KateredDesign/seedstick/THIRD_PARTY.md

# Third-party components

| Component | Where | Licence |
|---|---|---|
| **anatomy** (isometric figure kit), © 2026 Ryan, <https://github.com/wheresryan22/anatomy> | built into `docs/index.html` (light) and `docs/dark.html` | MIT |
| **U8g2** by Oliver Kraus, <https://github.com/olikraus/u8g2> | OLED library used by the firmware (not included, install via the Library Manager) | BSD 2-Clause |
| **Arduino core for the ESP32** by Espressif, <https://github.com/espressif/arduino-esp32> | board package (not included) | LGPL-2.1 |

## anatomy: MIT licence

```
MIT License

Copyright (c) 2026 Ryan

Permission is hereby granted, free of charge, to any person obtaining a copy
of this software and associated documentation files (the "Software"), to deal
in the Software without restriction, including without limitation the rights
to use, copy, modify, merge, publish, distribute, sublicense, and/or sell
copies of the Software, and to permit persons to whom the Software is
furnished to do so, subject to the following conditions:

The above copyright notice and this permission notice shall be included in all
copies or substantial portions of the Software.

THE SOFTWARE IS PROVIDED "AS IS", WITHOUT WARRANTY OF ANY KIND, EXPRESS OR
IMPLIED, INCLUDING BUT NOT LIMITED TO THE WARRANTIES OF MERCHANTABILITY,
FITNESS FOR A PARTICULAR PURPOSE AND NONINFRINGEMENT. IN NO EVENT SHALL THE
AUTHORS OR COPYRIGHT HOLDERS BE LIABLE FOR ANY CLAIM, DAMAGES OR OTHER
LIABILITY, WHETHER IN AN ACTION OF CONTRACT, TORT OR OTHERWISE, ARISING FROM,
OUT OF OR IN CONNECTION WITH THE SOFTWARE OR THE USE OR OTHER DEALINGS IN THE
SOFTWARE.
```
