KateredDesign/seedstick/docs/poster/SeedStick_Poster_A2.pdf

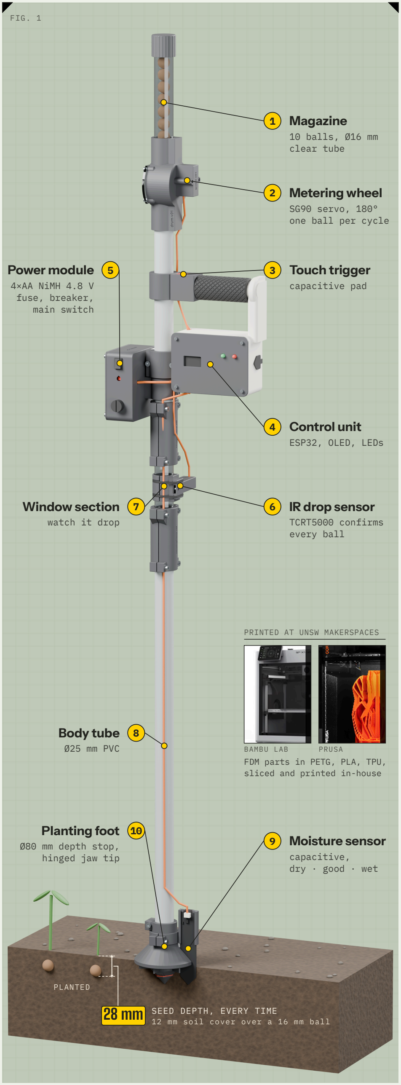
[picture p4: figure]
FIG. 1; 1 Magazine 10 balls, Ø16 mm clear tube; 2 Metering wheel SG90 servo, 180° one ball per cycle; 3 Touch trigger capacitive pad; 4 Control unit ESP32, OLED, LEDs; Power module 5 4×AA NiMH 4.8 V fuse, breaker, main switch; 6 IR drop sensor TCRT5000 confirms every ball; Window section 7 watch it drop; Body tube 8 Ø25 mm PVC; 9 Moisture sensor capacitive, dry · good · wet; Planting foot 10 Ø80 mm depth stop, hinged jaw tip; PLANTED; SEED DEPTH, EVERY TIME 12 mm soil cover over a 16 mm ball; PRINTED AT UNSW MAKERSPACES; BAMBU LAB; PRUSA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

FIG. 1 — SEEDSTICK PROTOTYPE IN THE SOIL. BLENDER RENDER.

UNSW BUILD-A-THON 2026 / RAMSOC × WIT | TRACK: RESTORATION

# SeedStick

One push.
Oneseed ball.
Every spot on record.

A hand-held planting tool for land restoration. It checks the soil, sets each seed ball at the same depth, and counts every one, so planting goes faster without losing care.

# 01 Restoration still moves at hand speed

# 1.2bn ha

of degraded land pledged for restoration by 2030

10.4%

of that area is actually under restoration today

# US$1.6tn

needed this decade, because the work is slow and manual

Seedlings are still placed by hand, a few hundred per person per day. Seeds sown over large areas often germinate poorly.

FIGURES: BUILD-A-THON 2026 BRIEF, PROBLEM 3: RESTORATION
02 Push. Read. Release. Confirm.

28

## 1 Push in

The depth stop sets
every seed ball exactly
28 mm deep.

MOISTURE

DRY GOOD WET

## 2 Read the soil

The moisture sensor
shows dry, good or wet
before you commit.

180°

## 3 Release one

A touch turns the
metering wheel 180°.
Exactly one ball drops.

+1

## 4 Confirm & log

An IR sensor sees it
pass. Count, time and
soil band are saved.

# 03 What it changes

Less labour Plant standing up: push, touch, move on. No bending, no digging, no counting.

Better starts Every ball at exactly 28 mm, and a soil check at every spot before it goes in.

Proof of work Every planting point is counted and logged, readable over the ESP32’s own Wi-Fi.

# 04 Safe by design

### Low voltage

4 × AA NiMH, 4.8 V. Far
below the 12 V limit.

### Double protection

Glass fuse plus a
resettable circuit
breaker.

### One main switch

A single rocker switch
cuts all power.

### Guarded mechanism

Wheel behind a clear
cover, servo under a
guard.

### Bolted together

Every module is bolted
on with heat-set inserts.

### 4×AA Sealed battery bay

Screwed lid: the cells
only come out with a
tool.

# Try it at ourtable

Push it in, touch the pad, and watch exactly one seed ball drop.

× | AUSTRALIA × GERMANY | The best mix of engineering. Trust theengineers.
SEEDSTICK · MECHATRONIC SOLUTION FOR ECOSYSTEM RESTORATION | FINAL SHOWCASE · 23 OCT 2026 · PRINCE HENRY CENTRE, UNSW
