KateredDesign/seedstick/hardware/bom.xlsx

SeedStick - Bill of Materials (bought and supplied parts)
Prices in AUD incl. GST. Printed parts and filament: see print-settings.md. Status: October 2026.
No. | Category | Part | Specification / part no. | Used for | Qty purchased | Unit | Qty used in SeedStick | Unit price (AUD) | Total price (AUD) | Supplier | Supply | Price basis | Notes
P01 | Tubes | Electrical conduit, grey, rigid, 25 mm Medium Duty | DETA 4 m x 25 mm MD rigid PVC conduit, AS/NZS 2053 (Bunnings p0829448) | Lower tube 554 mm, upper tube 300 mm | 1 | length (4 m) | 0.854 m | $6.57 | $6.57 | Bunnings | Purchased | List price (website) | Bought 2026-10-07; rest of the length for the fit test
P02 | Tubes | Plain coupling for 25 mm conduit, grey | DETA 25 mm grey PVC conduit plain coupling (Bunnings p0963383) | Couplings A and B | 4 | pcs | 2 | $0.35 | $1.40 | Bunnings | Purchased | List price (website) | Bought 2026-10-07; 2 spare
P03 | Tubes | Polycarbonate tube 22 ID x 25 OD x 305 mm | uxcell, Amazon AU B08LYZ6KQ5 | Sight tube 140 mm, magazine tube 155 mm | 1 | pcs | 1 | $25.19 | $25.19 | Amazon AU | Purchased | List price (website) | Ordered 2026-10-07
P04 | Power | Panel fuse holder M205 (5 x 20 mm), screw cap | Jaycar SZ2030 | Fine fuse in the power module front | 1 | pcs | 1 | $2.35 | $2.35 | Jaycar | Purchased | List price (website) | Jaycar list price
P05 | Power | Glass fuse 5 x 20 mm, T2A (slow blow) | M205 T2A | Fine fuse (one spare) | 2 | pcs | 1 | $1.40 | $2.80 | Jaycar | Purchased | Team entry
P06 | Power | Inline blade fuse holder (ATO) with leads | Jaycar SZ2040 | Holds the circuit breaker in the power module | 1 | pcs | 1 | $4.10 | $4.10 | Jaycar | Purchased | List price (website) | Jaycar list price
P07 | Power | Circuit breaker 10 A, manual reset, standard blade | Jaycar SF2333 | Required breaker (rulebook 6.1) | 1 | pcs | 1 | $6.59 | $6.59 | Jaycar | Purchased | List price (website) | Price AU$6.59 incl. GST from a third-party listing (localworks.doublet.com.au), not Jaycar's own page
P08 | Electronics | Electrolytic capacitor 1000 uF, >= 10 V, radial | max. 10 x 20 mm | Buffer at the servo (VSERVO) | 2 | pcs | 1 | $0.85 | $1.70 | Jaycar or Core Electronics | Purchased | Team entry
P09 | Electronics | Electrolytic capacitor 470 uF, >= 10 V, radial |  | Buffer at the ESP32 5V pin (V5) | 2 | pcs | 1 | $0.50 | $1.00 | Jaycar or Core Electronics | Purchased | Team entry
P10 | Electronics | Schottky diode 1N5819, 1 A 40 V | Jaycar ZR1020 | Between VSERVO and the ESP32 5V pin | 2 | pcs | 1 | $0.80 | $1.60 | Jaycar | Purchased | List price (website) | Jaycar AU list price, single unit
P11 | Electronics | ESP32 development board, 38 pins, USB-C | ESP32-WROOM (CP210x) | Controller | 1 | pcs | 1 | $0.00 | $0.00 | Build-a-thon basic kit / shop | Event shop (ticket) | No $ price (ticket / free) | from the event shop
P12 | Electronics | Breadboard 400 holes | half size | Wiring in the handle housing | 1 | pcs | 1 | $0.00 | $0.00 | Build-a-thon basic kit | Event shop (ticket) | No $ price (ticket / free) | Basic kit (handed out week 2)
P13 | Electronics | Dupont jumper wires (F-M, M-M) |  | Module connections, plug ends of the cables | 1 | set | some | $0.00 | $0.00 | Build-a-thon basic kit | Event shop (ticket) | No $ price (ticket / free) | Basic kit
P14 | Electronics | USB-C cable |  | Programming | 1 | pcs | 0 | $0.00 | $0.00 | Build-a-thon basic kit | Event shop (ticket) | No $ price (ticket / free) | Basic kit; not built into the stick
P15 | Electronics | OLED display 0.96 inch, I2C (SSD1306) | GM009605 v4.3, 128 x 64 | Display in the front panel | 1 | pcs | 1 | $0.00 | $0.00 | Event shop | Event shop (ticket) | No $ price (ticket / free) | A tier
P16 | Electronics | IR reflective sensor module TCRT5000 | 3 pins (GND, OUT, VCC) | Counts the balls (irClip) | 1 | pcs | 1 | $0.00 | $0.00 | Event shop | Event shop (ticket) | No $ price (ticket / free) | B tier
P17 | Electronics | Micro servo SG90 |  | Metering wheel | 1 | pcs | 1 | $0.00 | $0.00 | Event shop | Event shop (ticket) | No $ price (ticket / free) | B tier
P18 | Electronics | Soil moisture sensor, capacitive v2.0 | HW-390 type | Moisture in the soil (foot) | 1 | pcs | 1 | $0.00 | $0.00 | Event shop | Event shop (ticket) | No $ price (ticket / free) | from the event shop
P19 | Power | Battery holder 4 x AA with leads |  | Battery pack | 1 | pcs | 1 | $0.00 | $0.00 | Event shop | Event shop (ticket) | No $ price (ticket / free) | B tier
P20 | Electronics | LED 5 mm, red and green |  | Status LEDs in the front panel | 2 | pcs | 2 | $0.00 | $0.00 | Event shop | Event shop (ticket) | No $ price (ticket / free) | C tier
P21 | Power | Rocker switch (KCD11) |  | Main switch | 1 | pcs | 1 | $0.00 | $0.00 | Event shop | Event shop (ticket) | No $ price (ticket / free) | C tier
P22 | Electronics | Capacitive touch module TTP223 |  | Touch button on the handle | 1 | pcs | 1 | $0.00 | $0.00 | Event shop | Event shop (ticket) | No $ price (ticket / free) | C tier
P23 | Hardware | Heat-set insert M2 | brass, 3.5 mm OD | OLED bracket 2, servo cover 2 | 4 | pcs | 4 | $0.00 | $0.00 | MCIC Makerspace | MCIC Makerspace | No $ price (ticket / free) | from the MCIC makerspace
P24 | Hardware | Heat-set insert M3 | brass, 5 mm OD | Sight cover 4, battery lid 4 | 8 | pcs | 8 | $0.00 | $0.00 | MCIC Makerspace | MCIC Makerspace | No $ price (ticket / free) | from the MCIC makerspace
P25 | Hardware | Screw M2 x 6 |  | OLED bracket 2, servo cover 2 | 4 | pcs | 4 | $0.00 | $0.00 | MCIC Makerspace | MCIC Makerspace | No $ price (ticket / free)
P26 | Hardware | Screw M2 x 12 |  | Jaw pivots on the foot | 2 | pcs | 2 | $0.00 | $0.00 | MCIC Makerspace | MCIC Makerspace | No $ price (ticket / free)
P27 | Hardware | Screw M2.5 x 6 |  | IR module in the irClip | 2 | pcs | 2 | $0.00 | $0.00 | MCIC Makerspace | MCIC Makerspace | No $ price (ticket / free)
P28 | Hardware | Screw M2.5 x 8 |  | Front panel | 4 | pcs | 4 | $0.00 | $0.00 | MCIC Makerspace | MCIC Makerspace | No $ price (ticket / free)
P29 | Hardware | Screw M3 x 8 |  | Sight cover 4, battery lid 4 | 8 | pcs | 8 | $0.00 | $0.00 | MCIC Makerspace | MCIC Makerspace | No $ price (ticket / free)
P30 | Hardware | Screw M4 x 20 |  | Grip clamps 3, power module 1, coupling clamps 8, foot 1, sensor holder 2 | 15 | pcs | 15 | $0.00 | $0.00 | MCIC Makerspace | MCIC Makerspace | No $ price (ticket / free)
P31 | Hardware | Nut M4 (7 mm AF) |  | With the M4 x 20 screws | 15 | pcs | 15 | $0.00 | $0.00 | MCIC Makerspace | MCIC Makerspace | No $ price (ticket / free)
P32 | Hardware | Nut M2.5 (5 mm AF) |  | Front panel | 4 | pcs | 4 | $0.00 | $0.00 | MCIC Makerspace | MCIC Makerspace | No $ price (ticket / free)
P33 | Electronics | Resistor 150 ohm, 1/4 W |  | LED series resistors | 2 | pcs | 2 | $0.00 | $0.00 | MCIC Makerspace | MCIC Makerspace | No $ price (ticket / free) | from the MCIC makerspace
P34 | Electronics | Resistor 100 kohm, 1/4 W |  | Battery voltage divider (GPIO 35) | 2 | pcs | 2 | $0.00 | $0.00 | MCIC Makerspace | MCIC Makerspace | No $ price (ticket / free) | from the MCIC makerspace
P35 | Consumables | Hook-up wire 24 / 26 / 28 AWG (red, black, yellow, orange) |  | Harness, moisture, IR, touch, LED cables | 1 | set | about 1 m each | $0.00 | $0.00 | Makerspace | MCIC Makerspace | No $ price (ticket / free)
P36 | Consumables | Solid wire 0.6 mm (22 AWG) |  | 4 bridges under the ESP32 | 1 | set | 4 | $0.00 | $0.00 | Makerspace | MCIC Makerspace | No $ price (ticket / free)
P37 | Consumables | Pin header 2.54 mm, 3 pins |  | Servo socket | 1 | pcs | 1 | $0.00 | $0.00 | Makerspace | MCIC Makerspace | No $ price (ticket / free)
P38 | Consumables | Solder, heat shrink 1.5-6 mm, hot glue |  | Every solder joint, securing plugs | 1 | set | little | $0.00 | $0.00 | Makerspace | MCIC Makerspace | No $ price (ticket / free)
P39 | Consumables | 2-part epoxy (5 or 30 min) |  | Horn glued into the metering wheel | 1 | set | little | $0.00 | $0.00 | Makerspace | MCIC Makerspace | No $ price (ticket / free)
P40 | Laser part | Acrylic (PMMA) 3 mm, clear, offcut approx. 70 x 70 mm | hardware/laser/sight-cover.dxf | Sight cover of the metering module (laser cut) | 1 | pcs | 1 | $0.00 | $0.00 | Makerspace (laser) | MCIC Makerspace | No $ price (ticket / free) | laser cut in the makerspace
P41 | Consumables | Cyanoacrylate glue (super glue) and 1.75 mm filament offcut |  | Gluing the 12 dummy balls (2 pins of 4.6 mm each) | 1 | set | little | $0.00 | $0.00 | Makerspace | MCIC Makerspace | No $ price (ticket / free) | for the printed dummy balls
 |  |  |  | Total spent (purchased parts) |  |  |  |  | $53.30
 |  |  |  | Items from the event shop / MCIC makerspace / already owned |  |  |  |  | 12 / 19 / 0
