KateredDesign/seedstick/docs/images/parts/battery-holder-4xaa-ruler.jpg

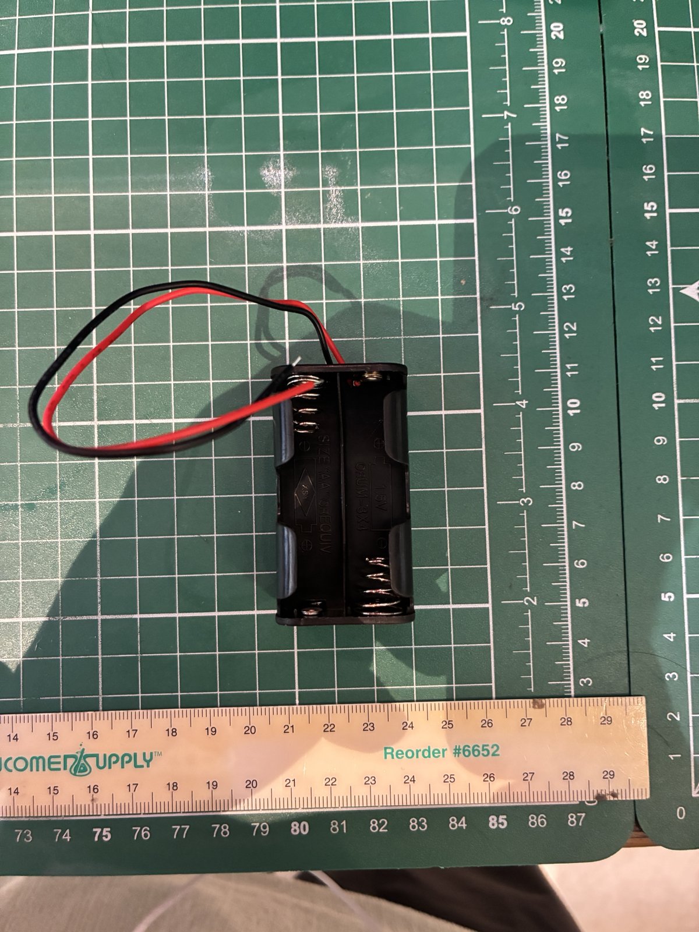
docs/images/parts/battery-holder-4xaa-ruler.jpg
