KateredDesign/seedstick/docs/images/parts/breadboard.jpg

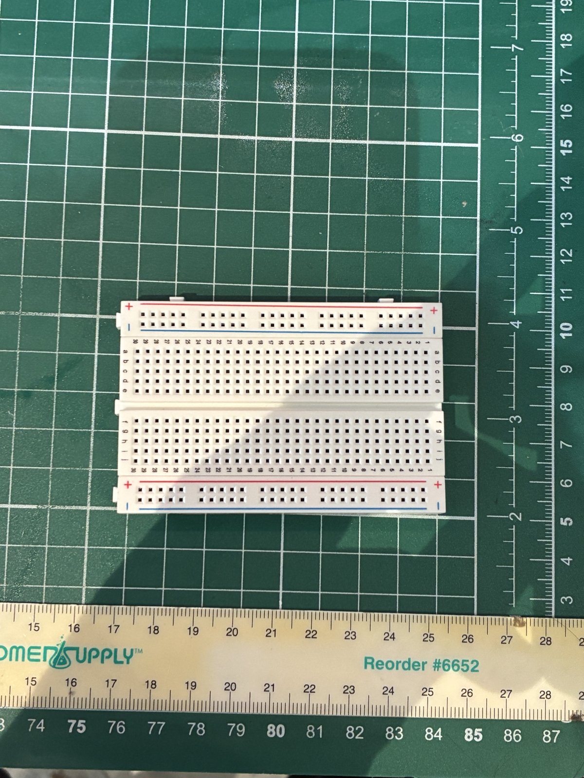
docs/images/parts/breadboard.jpg
