KateredDesign/seedstick/docs/images/parts/circuit-breaker-back-ruler.jpg

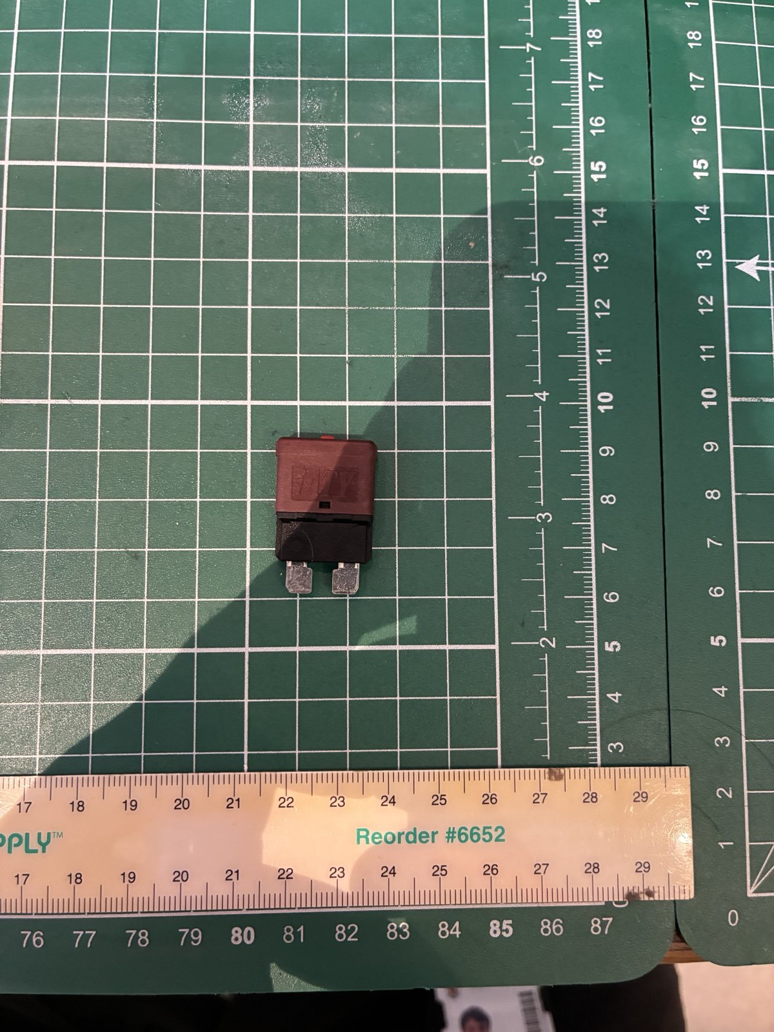
docs/images/parts/circuit-breaker-back-ruler.jpg
