KateredDesign/seedstick/docs/images/parts/circuit-breaker-back.jpg

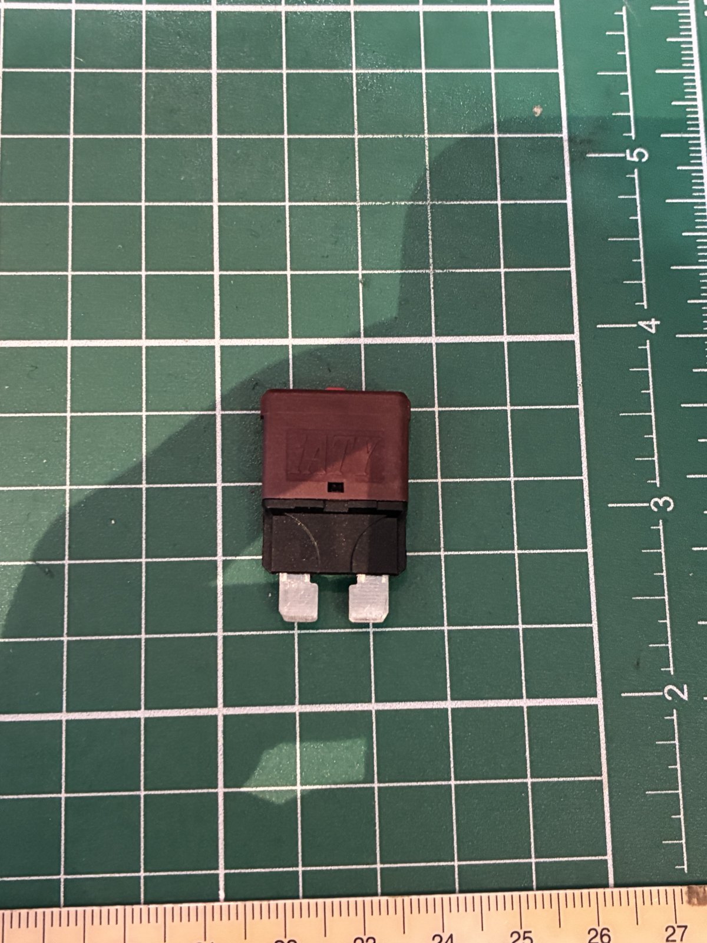
docs/images/parts/circuit-breaker-back.jpg
