KateredDesign/seedstick/docs/images/parts/circuit-breaker-front-ruler.jpg

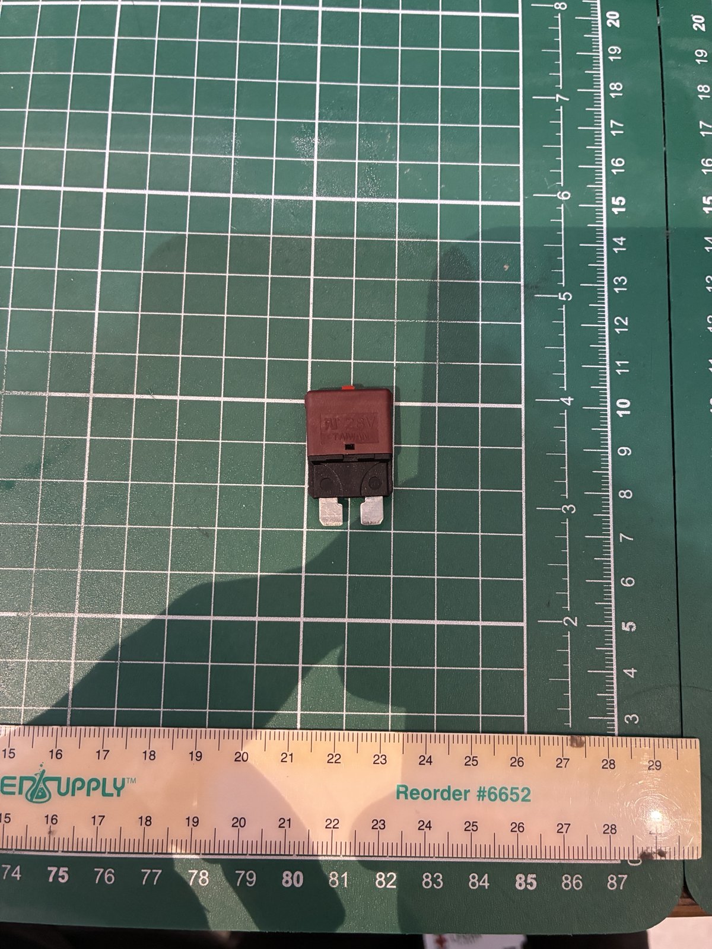
docs/images/parts/circuit-breaker-front-ruler.jpg
