KateredDesign/seedstick/docs/images/parts/circuit-breaker-front.jpg

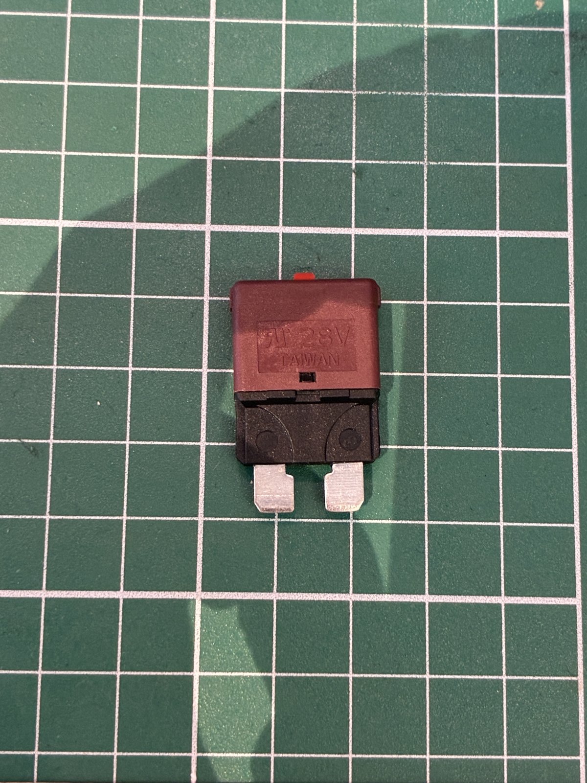
docs/images/parts/circuit-breaker-front.jpg
