KateredDesign/seedstick/docs/images/parts/coupling-outer-diameter.jpg

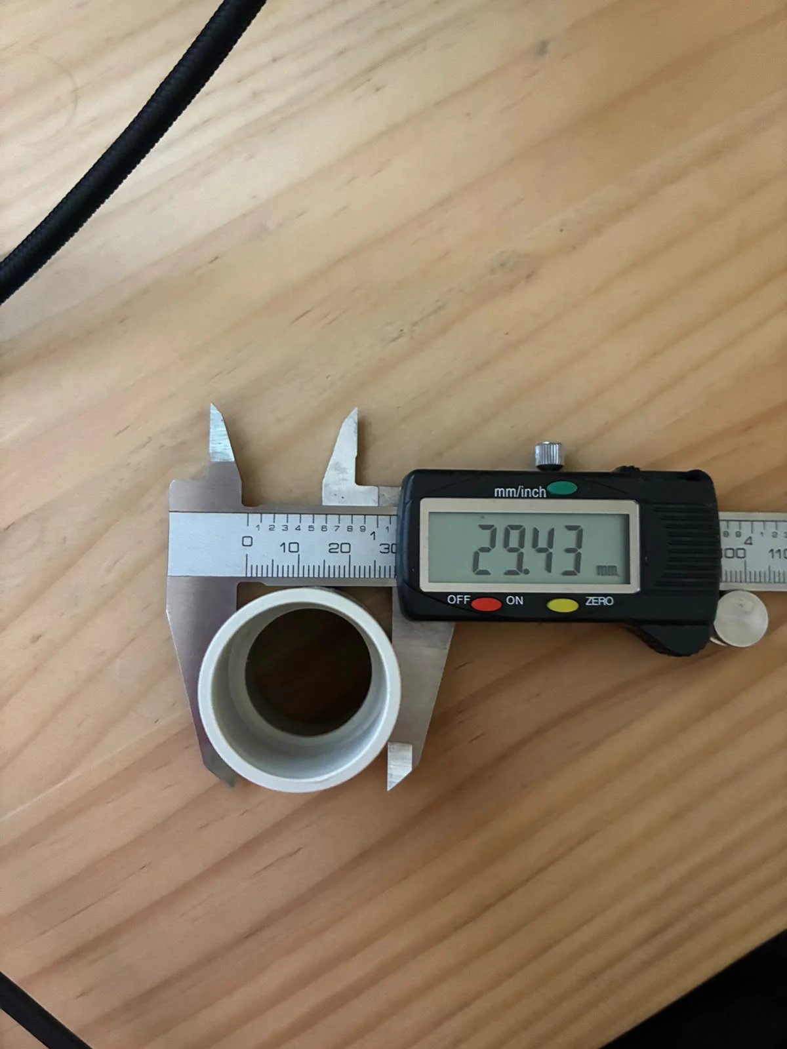
docs/images/parts/coupling-outer-diameter.jpg
