KateredDesign/seedstick/docs/images/parts/esp32-on-breadboard.jpg

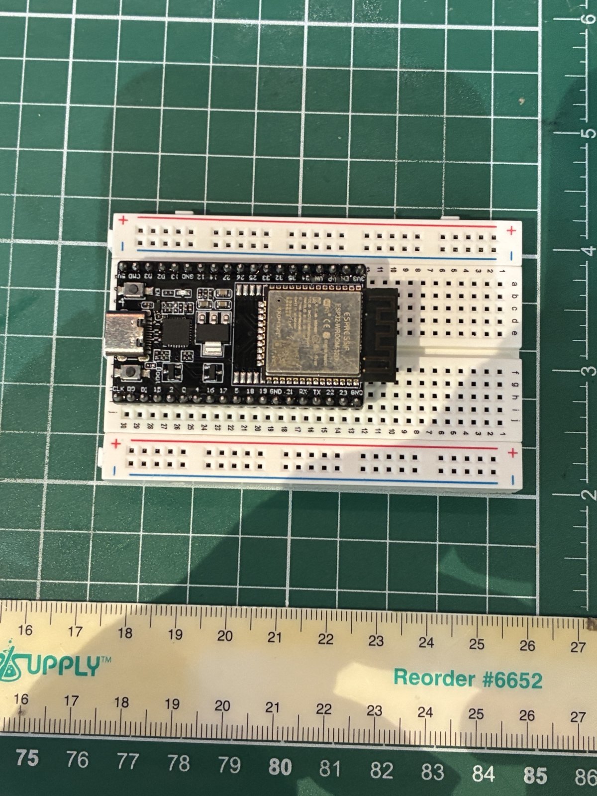
docs/images/parts/esp32-on-breadboard.jpg
