KateredDesign/seedstick/docs/images/parts/esp32-top-ruler.jpg

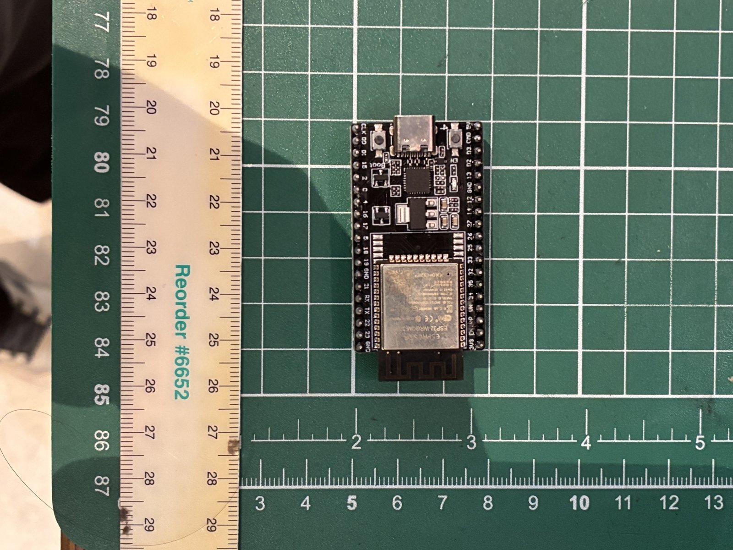
docs/images/parts/esp32-top-ruler.jpg
