KateredDesign/seedstick/docs/images/parts/esp32-usb-side.jpg

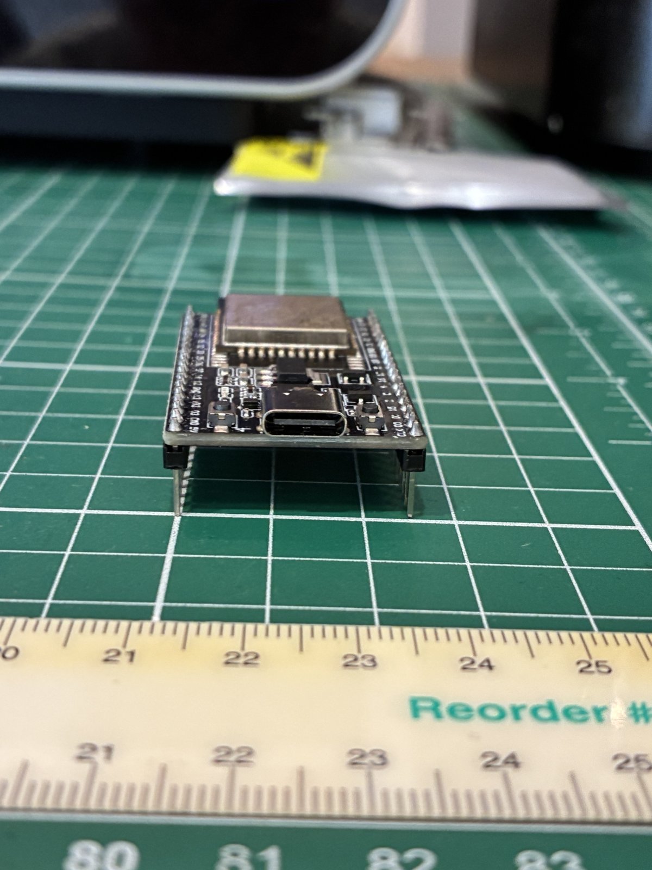
docs/images/parts/esp32-usb-side.jpg
