KateredDesign/seedstick/docs/images/parts/ir-sensor-tcrt5000-back.jpg

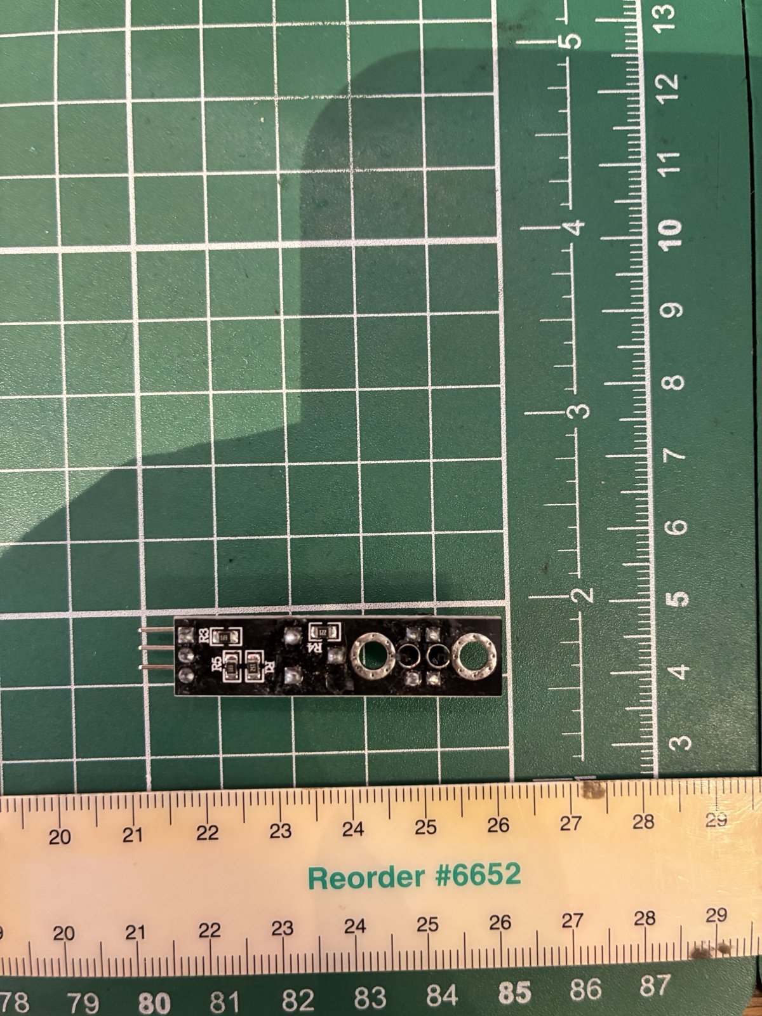
docs/images/parts/ir-sensor-tcrt5000-back.jpg
