KateredDesign/seedstick/docs/images/parts/ir-sensor-tcrt5000-front.jpg

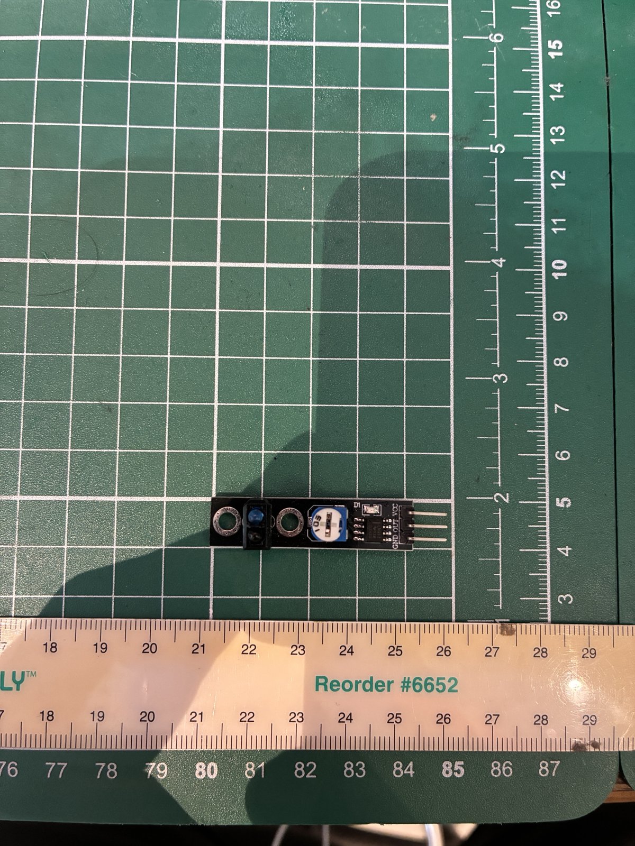
docs/images/parts/ir-sensor-tcrt5000-front.jpg
