KateredDesign/seedstick/docs/images/parts/leds-5mm.jpg

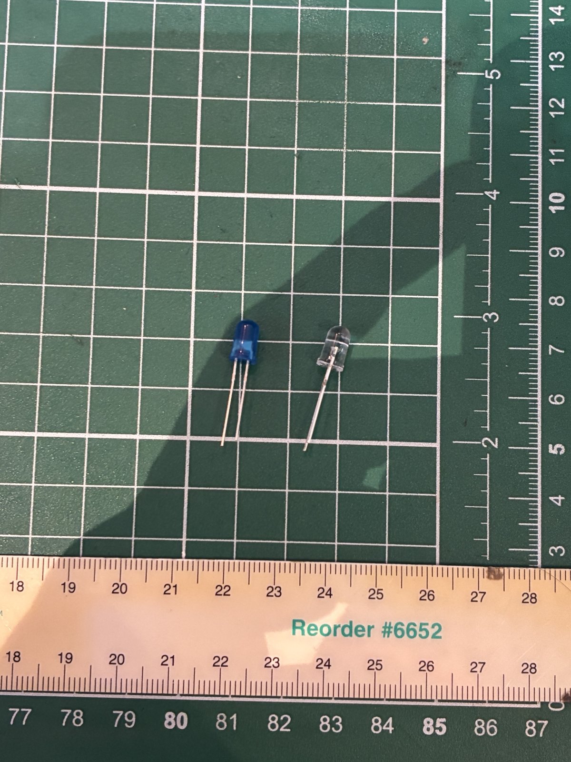
docs/images/parts/leds-5mm.jpg
