KateredDesign/seedstick/docs/images/parts/moisture-sensor-ruler.jpg

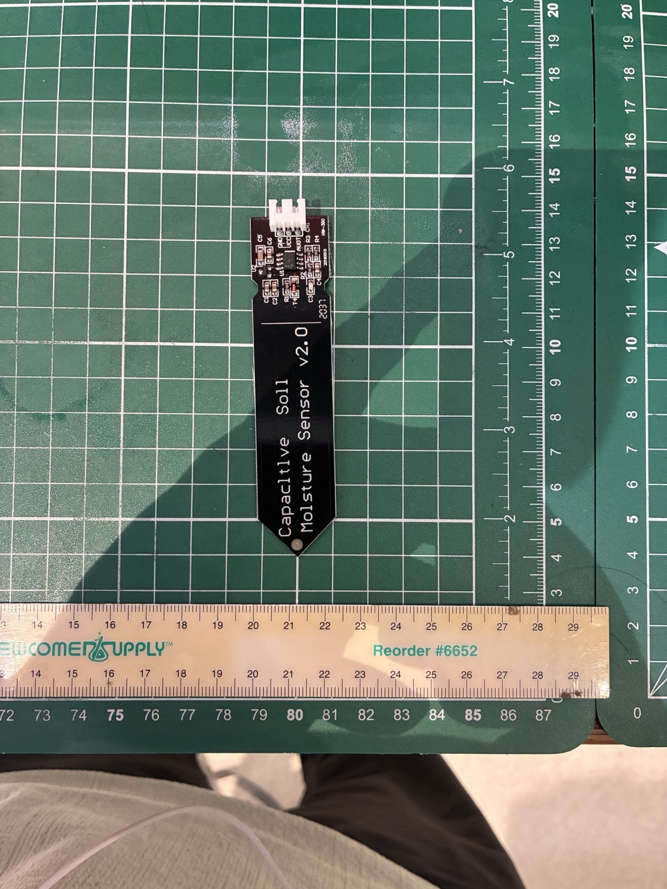
docs/images/parts/moisture-sensor-ruler.jpg
