KateredDesign/seedstick/docs/images/parts/oled-back.jpg

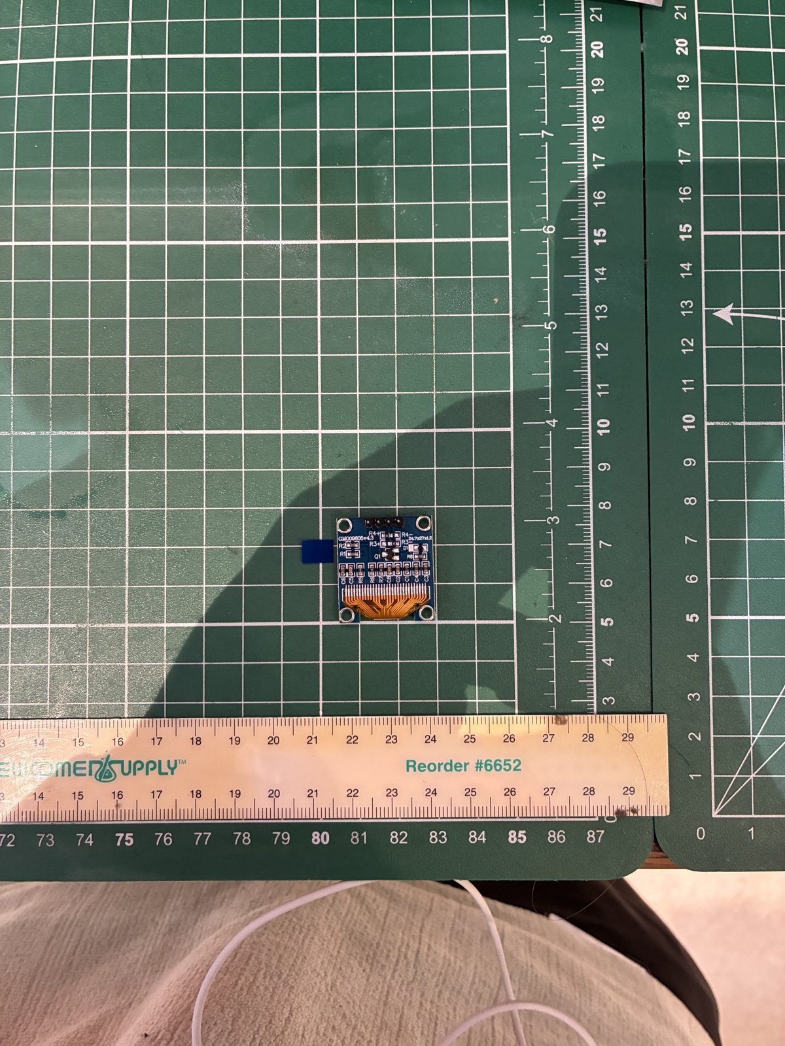
docs/images/parts/oled-back.jpg
