KateredDesign/seedstick/docs/images/parts/oled-front-close.jpg

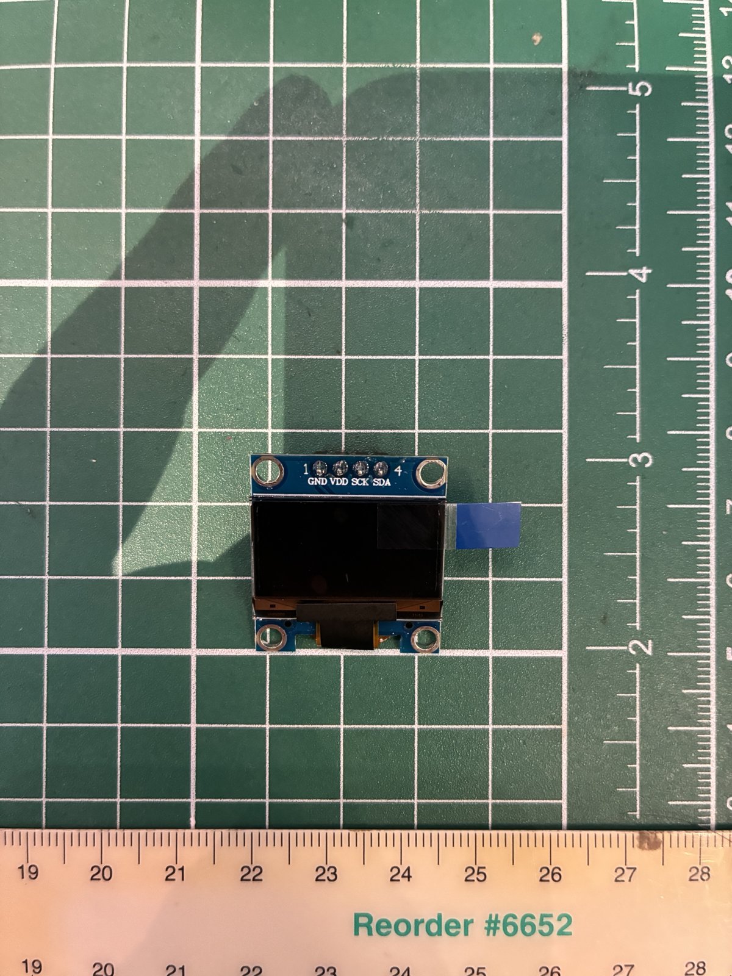
docs/images/parts/oled-front-close.jpg
