KateredDesign/seedstick/docs/images/parts/oled-front-ruler.jpg

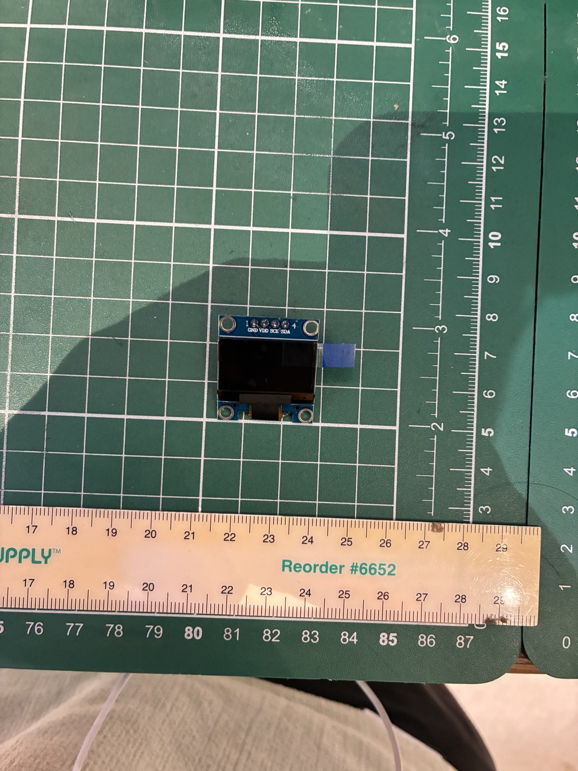
docs/images/parts/oled-front-ruler.jpg
