KateredDesign/seedstick/docs/images/parts/rocker-switch-kcd11-ruler.jpg

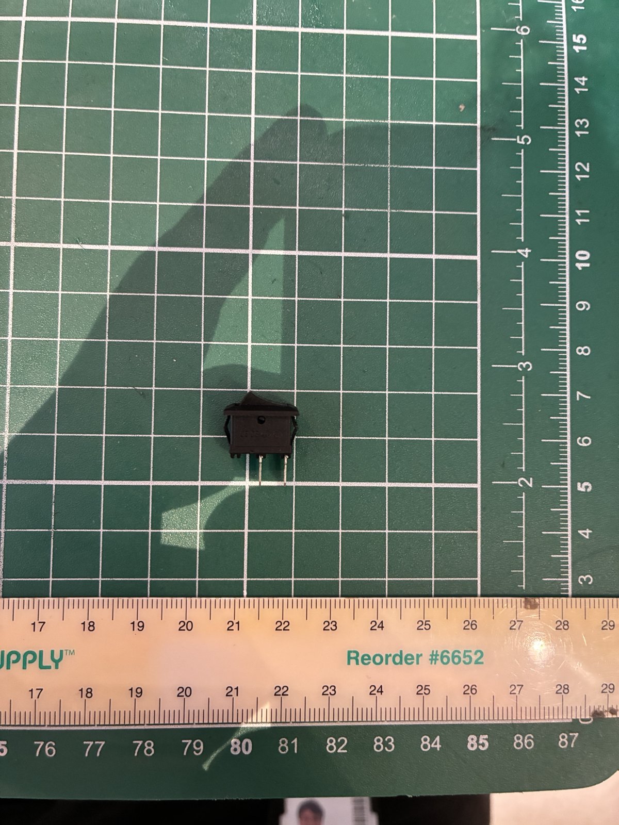
docs/images/parts/rocker-switch-kcd11-ruler.jpg
