KateredDesign/seedstick/docs/images/parts/rocker-switch-kcd11-side-1.jpg

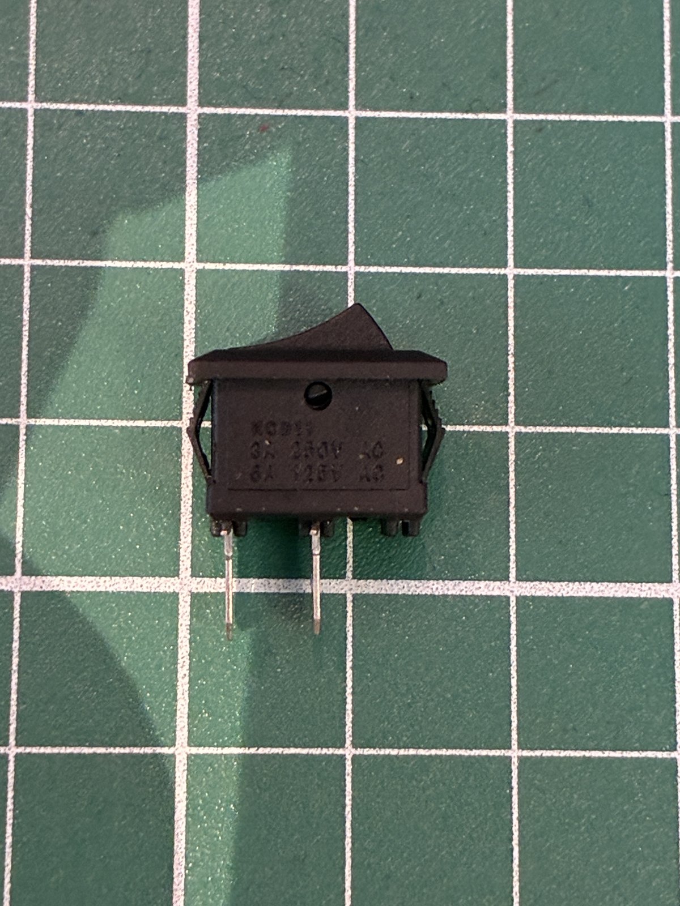
docs/images/parts/rocker-switch-kcd11-side-1.jpg
