KateredDesign/seedstick/docs/images/parts/rocker-switch-kcd11-side-2.jpg

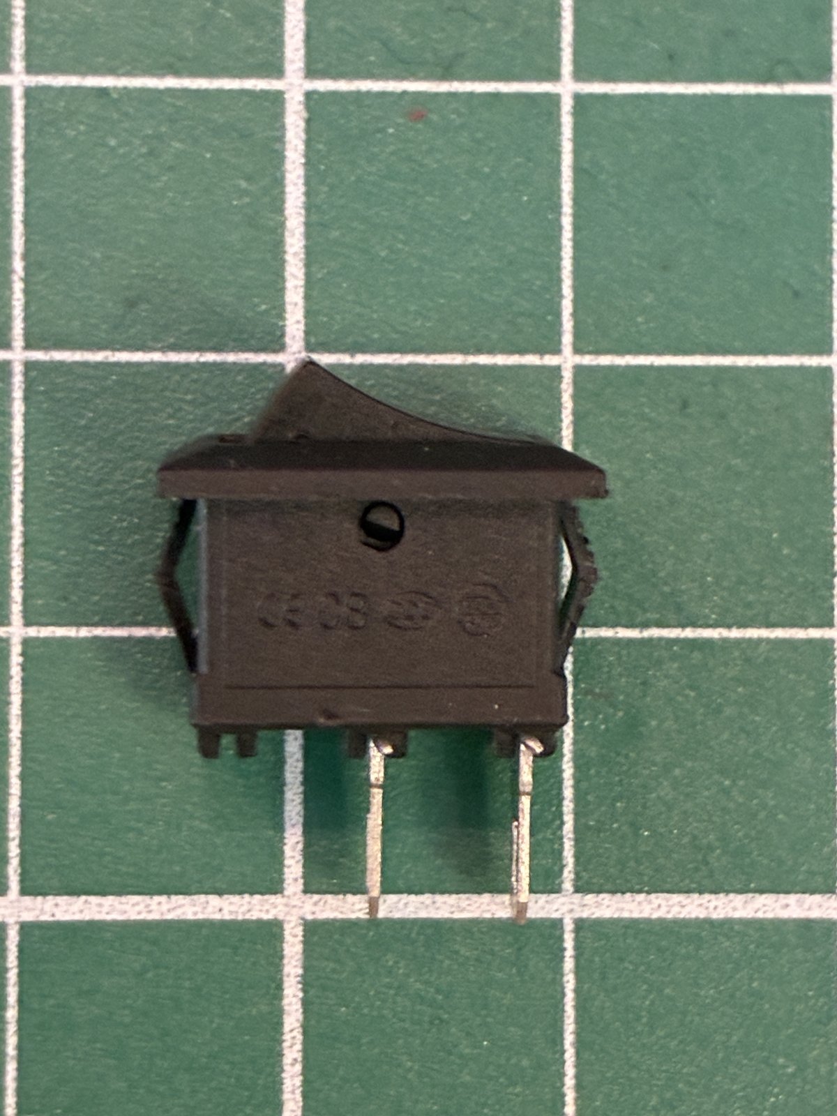
docs/images/parts/rocker-switch-kcd11-side-2.jpg
