KateredDesign/seedstick/docs/images/parts/touch-module-back-flat.jpg

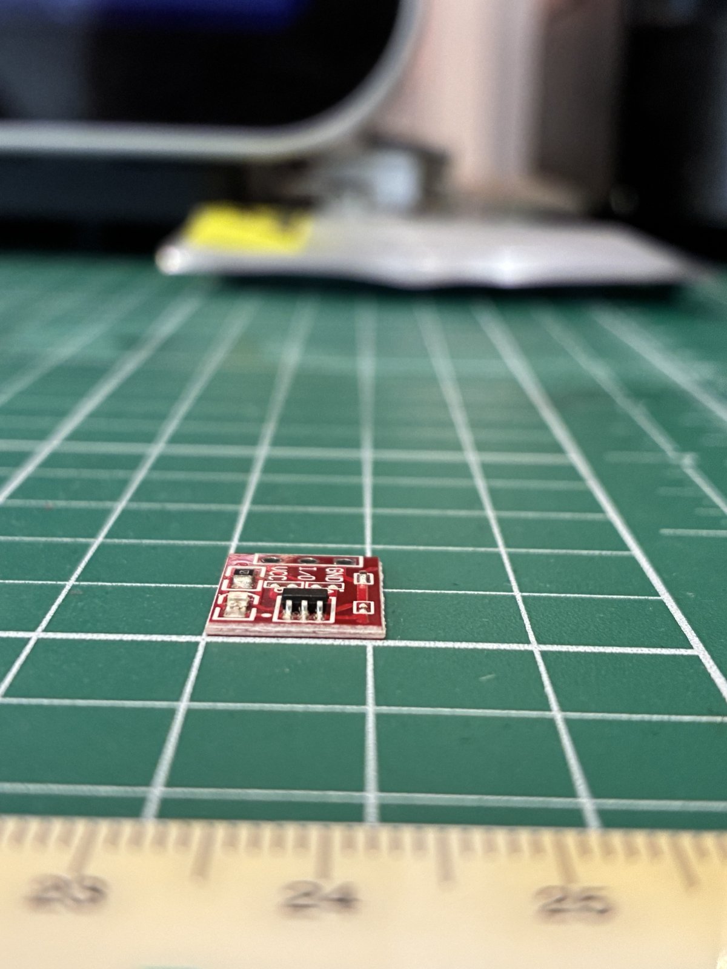
docs/images/parts/touch-module-back-flat.jpg
