KateredDesign/seedstick/docs/images/parts/touch-module-back.jpg

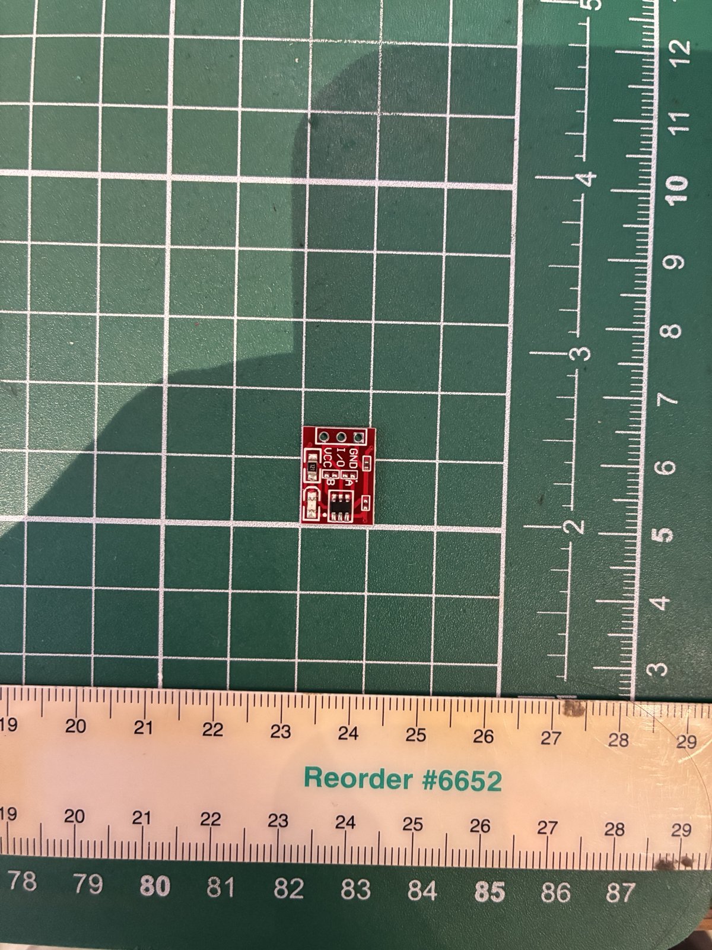
docs/images/parts/touch-module-back.jpg
