KateredDesign/seedstick/docs/images/parts/touch-module-front.jpg

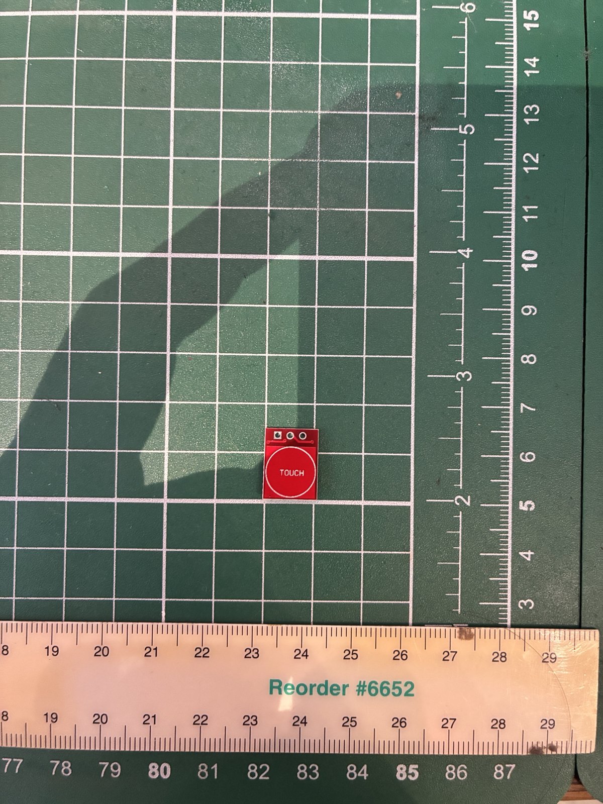
docs/images/parts/touch-module-front.jpg
