KateredDesign/seedstick/hardware/laser/sight-cover.dxf

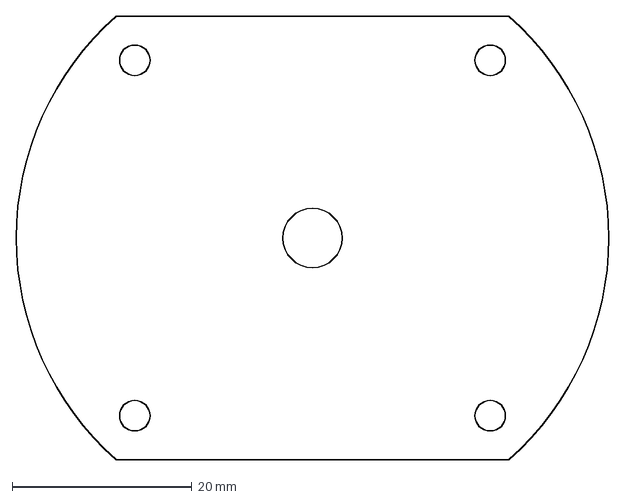
[picture p28: CAD file, 2026-10-27]
hardware/laser/sight-cover.dxf
66.0 x 49.4 mm
