KateredDesign/seedstick/hardware/stl/accessories/dummy-ball-half.stl

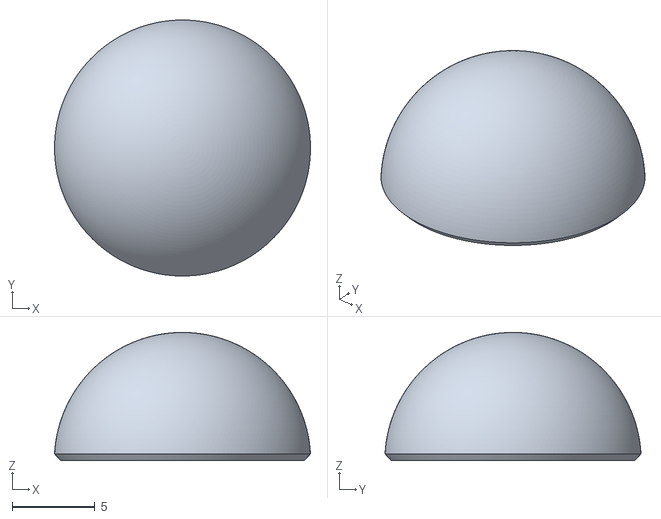
[picture p29: CAD file, 2026-10-27]
hardware/stl/accessories/dummy-ball-half.stl
15.5 x 15.5 x 7.75
