KateredDesign/seedstick/hardware/stl/calibration/seed-ball-gauge.stl

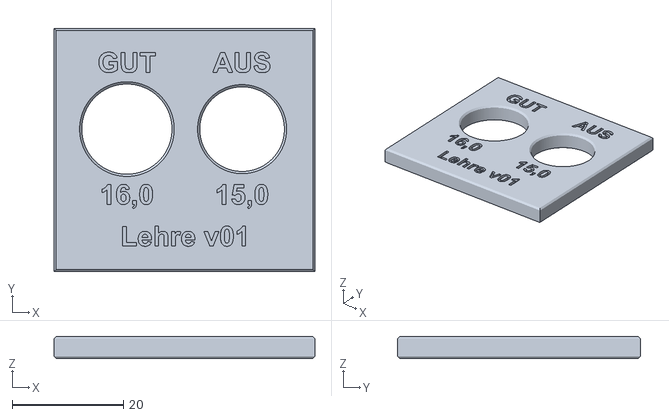
[picture p30: CAD file, 2026-10-27]
hardware/stl/calibration/seed-ball-gauge.stl
46.9 x 43.7 x 4.00
