KateredDesign/seedstick/hardware/stl/device/ir-clip-back.stl

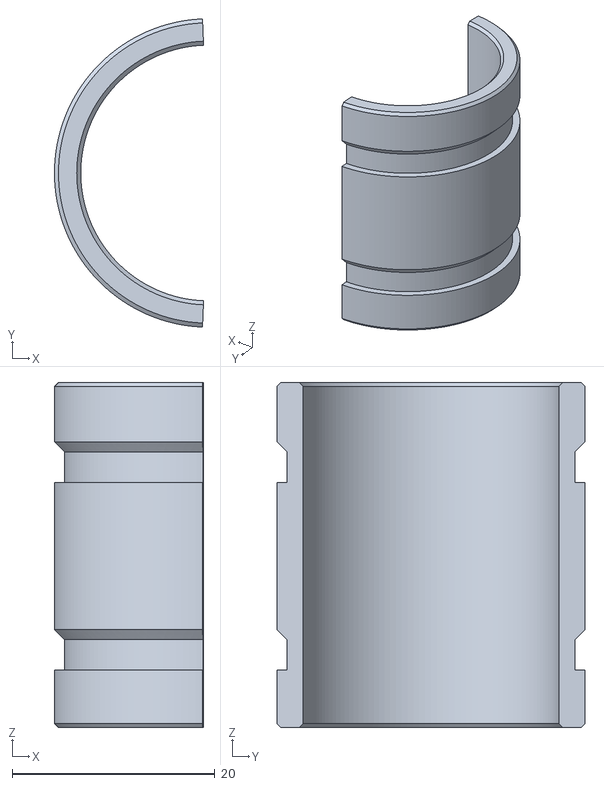
[picture p31: CAD file, 2026-10-27]
hardware/stl/device/ir-clip-back.stl
14.7 x 30.4 x 34.0
