KateredDesign/seedstick/hardware/stl/accessories/dummy-ball-plate-24.stl

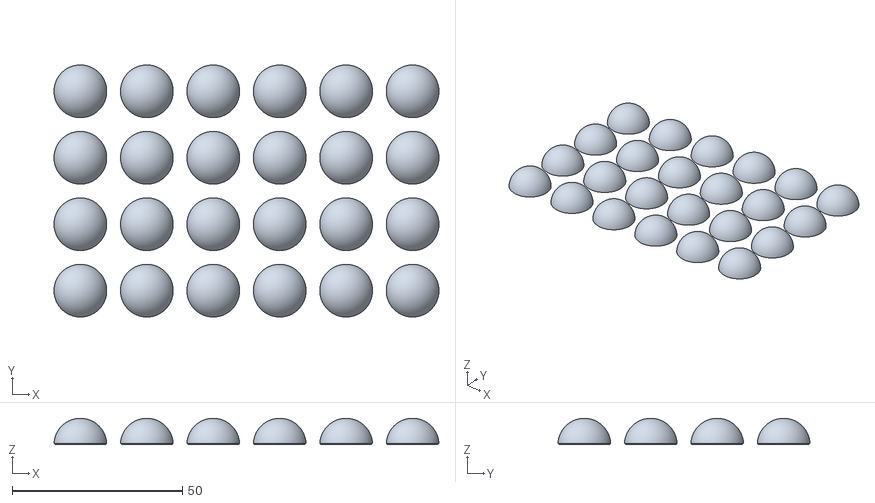
[picture p32: CAD file, 2026-10-27]
hardware/stl/accessories/dummy-ball-plate-24.stl
113.0 x 74.0 x 7.75
