KateredDesign/seedstick/hardware/stl/calibration/fit-test-card.stl

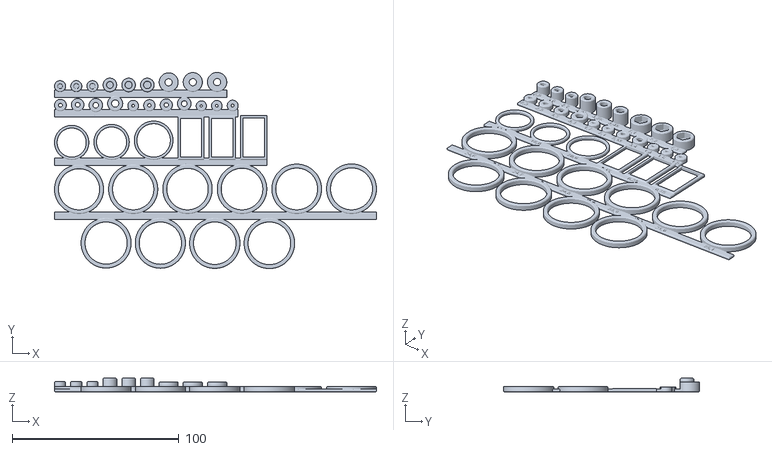
[picture p33: CAD file, 2026-10-27]
hardware/stl/calibration/fit-test-card.stl
192.9 x 117.5 x 8.10
