KateredDesign/seedstick/hardware/stl/device/sensor-holder-front.stl

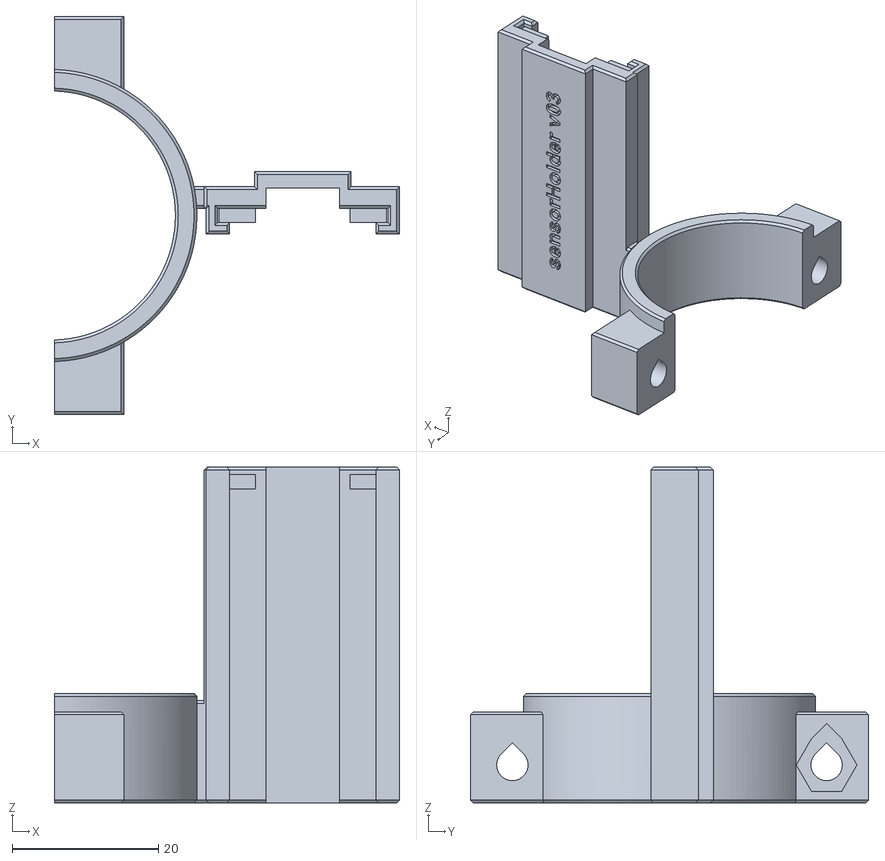
[picture p34: CAD file, 2026-10-27]
hardware/stl/device/sensor-holder-front.stl
47.2 x 54.6 x 46.0
