KateredDesign/seedstick/hardware/stl/accessories/showcase-stand.stl

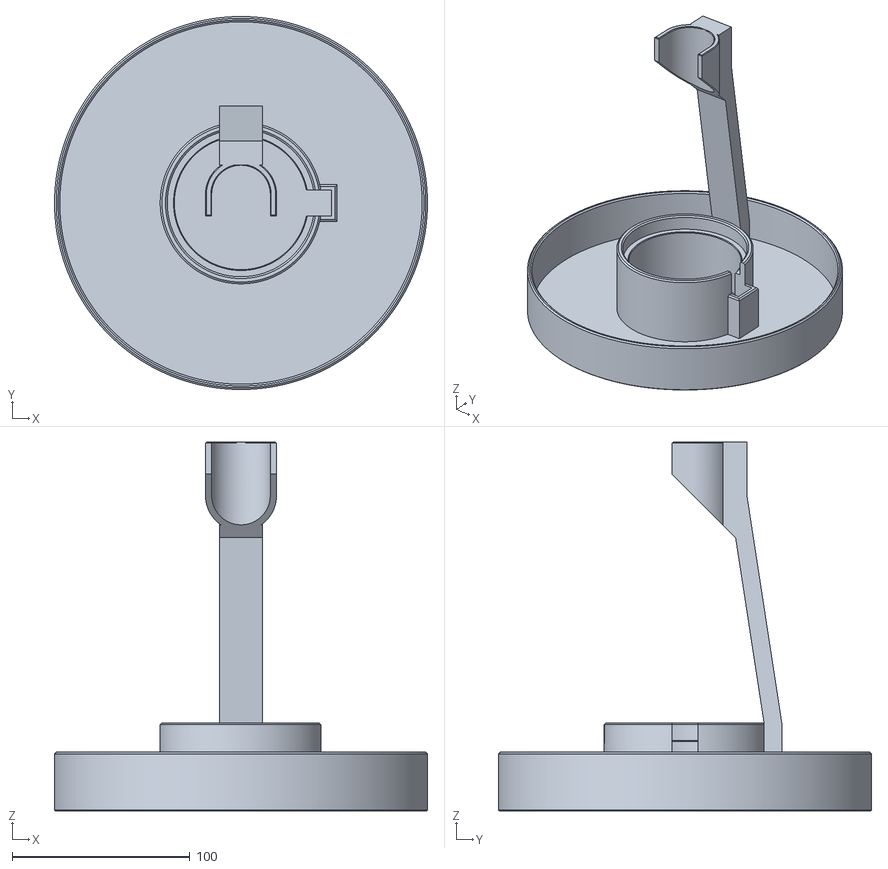
[picture p35: CAD file, 2026-10-27]
hardware/stl/accessories/showcase-stand.stl
210.0 x 210.0 x 207.5
