KateredDesign/seedstick/hardware/stl/calibration/seed-ball-mould-half.stl

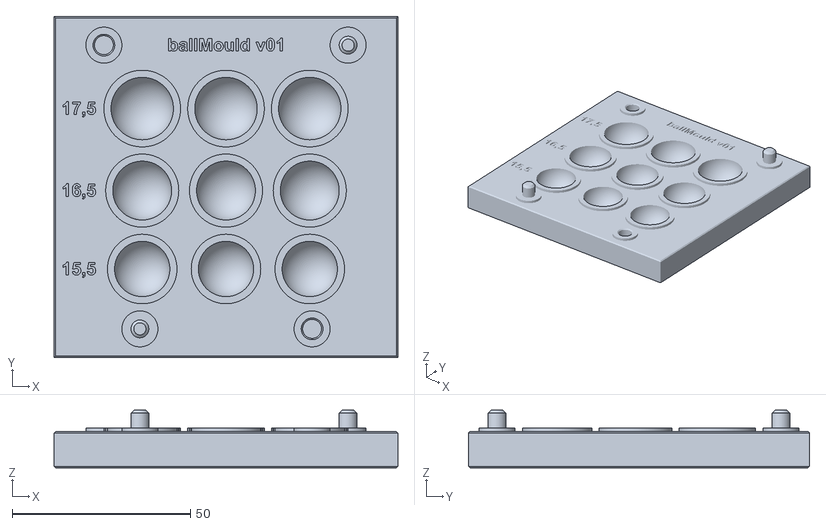
[picture p36: CAD file, 2026-10-27]
hardware/stl/calibration/seed-ball-mould-half.stl
96.5 x 95.7 x 16.1
