KateredDesign/seedstick/hardware/stl/device/usb-plug.stl

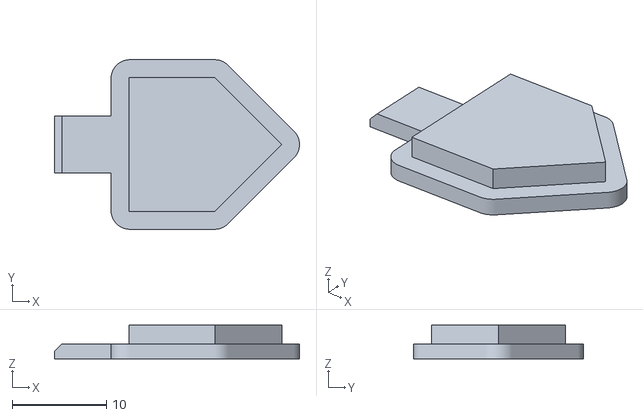
[picture p37: CAD file, 2026-10-27]
hardware/stl/device/usb-plug.stl
26.0 x 18.0 x 3.60
