KateredDesign/seedstick/hardware/stl/device/foot.stl

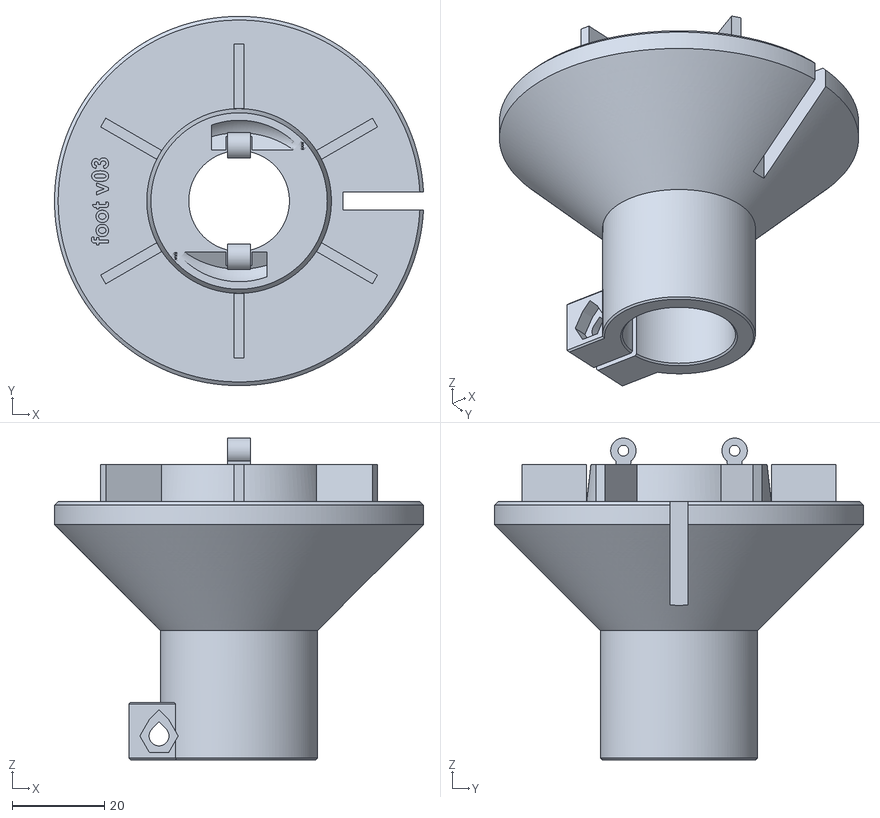
[picture p38: CAD file, 2026-10-27]
hardware/stl/device/foot.stl
80.0 x 80.0 x 69.8
