KateredDesign/seedstick/hardware/stl/device/servo-cover.stl

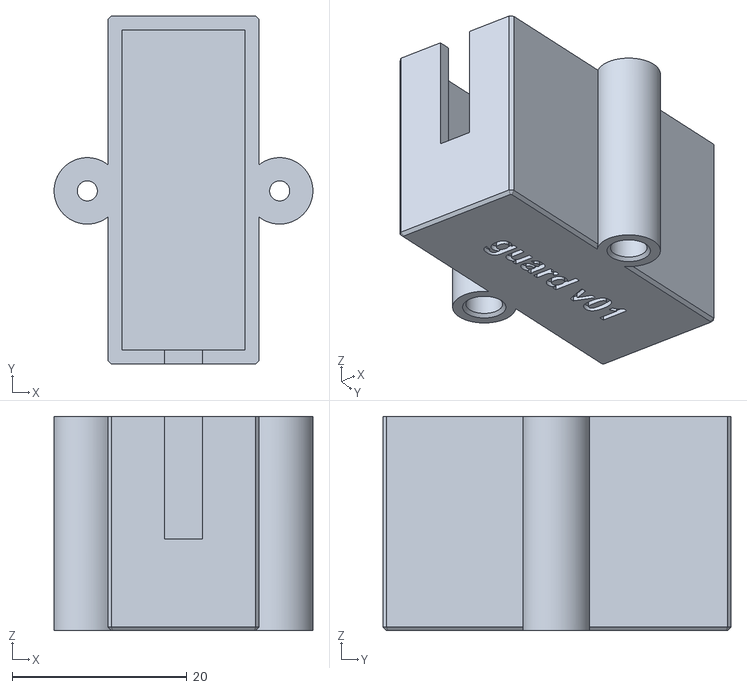
[picture p39: CAD file, 2026-10-27]
hardware/stl/device/servo-cover.stl
29.6 x 39.8 x 24.5
