KateredDesign/seedstick/hardware/stl/device/power-box.stl

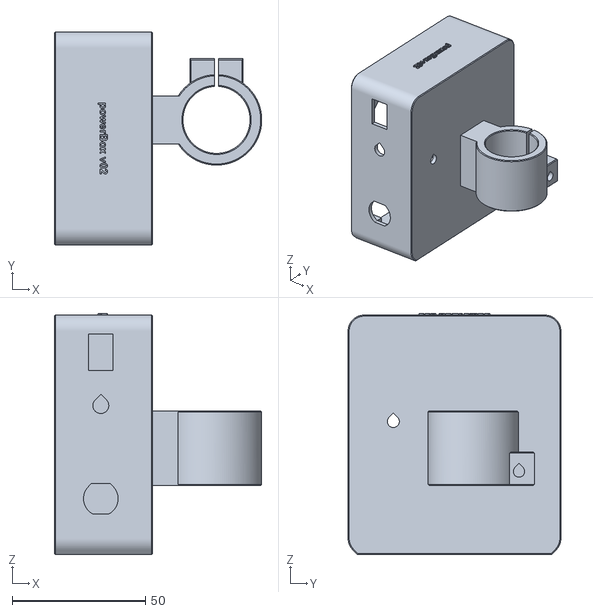
[picture p40: CAD file, 2026-10-27]
hardware/stl/device/power-box.stl
78.0 x 80.0 x 90.6
