KateredDesign/seedstick/hardware/stl/device/ir-hood.stl

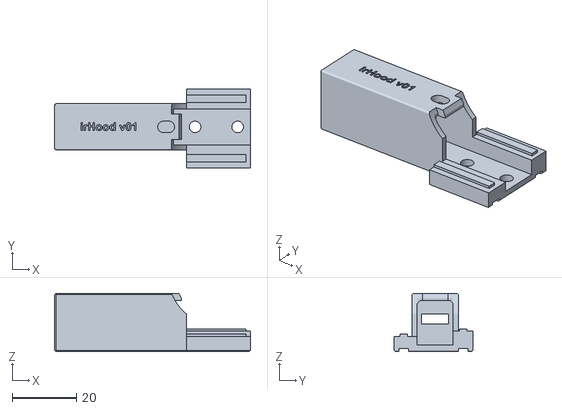
[picture p41: CAD file, 2026-10-27]
hardware/stl/device/ir-hood.stl
61.2 x 24.7 x 18.2
