KateredDesign/seedstick/hardware/stl/device/magazine-cap.stl

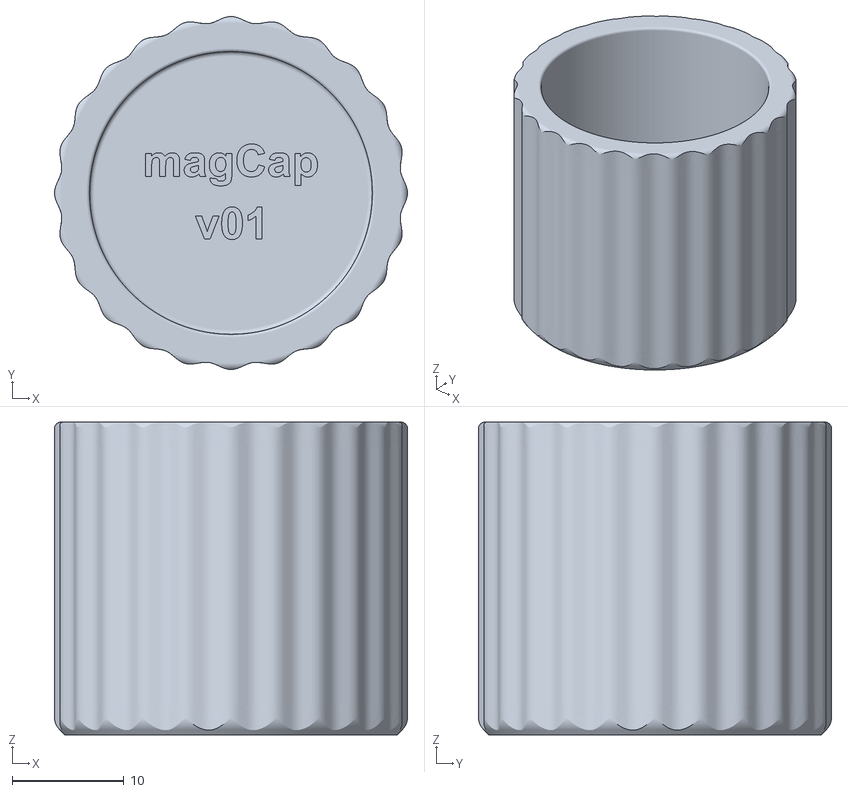
[picture p42: CAD file, 2026-10-27]
hardware/stl/device/magazine-cap.stl
31.6 x 31.6 x 28.0
