KateredDesign/seedstick/hardware/stl/device/ir-clip-front.stl

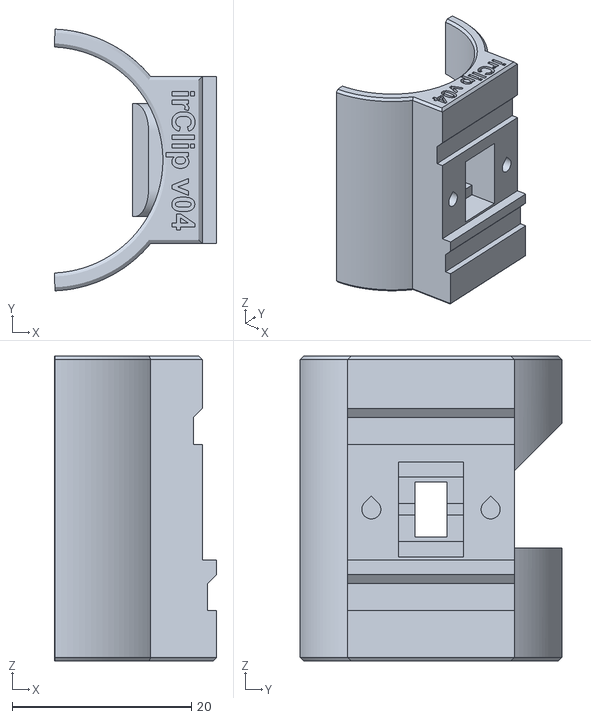
[picture p43: CAD file, 2026-10-27]
hardware/stl/device/ir-clip-front.stl
18.1 x 29.2 x 34.0
