KateredDesign/seedstick/hardware/stl/device/front-panel.stl

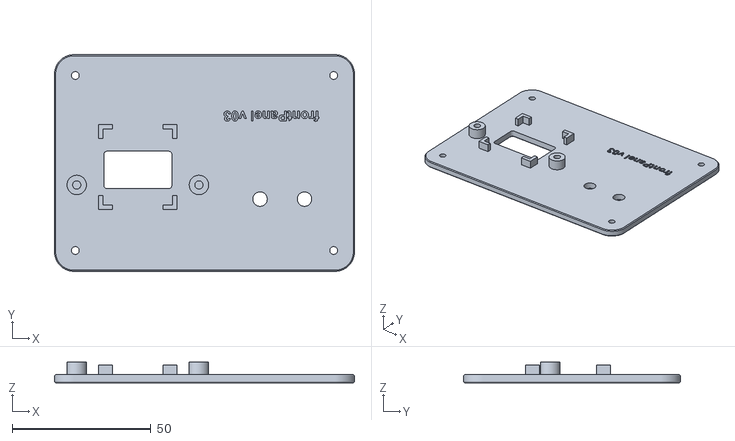
[picture p44: CAD file, 2026-10-27]
hardware/stl/device/front-panel.stl
108.0 x 78.0 x 7.40
