KateredDesign/seedstick/hardware/stl/device/coupling-clamp-left.stl

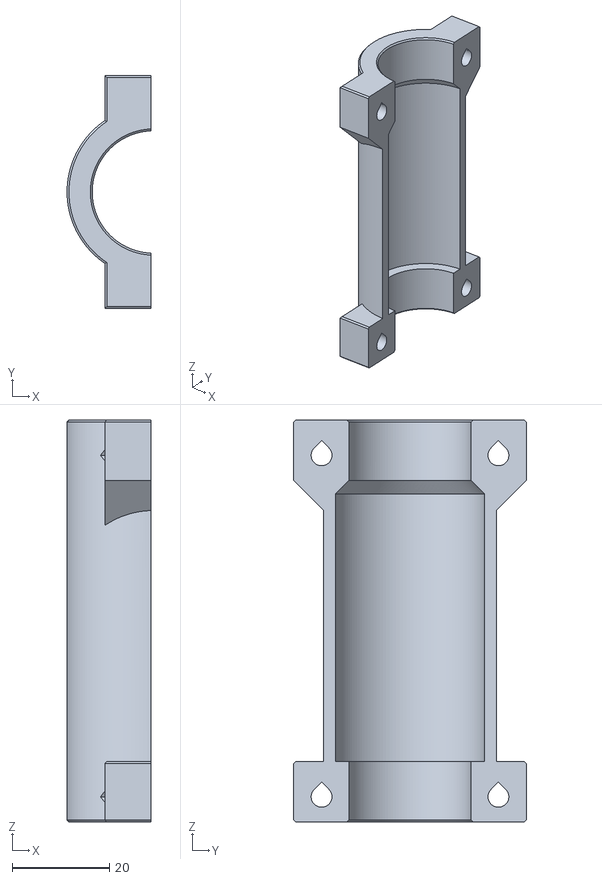
[picture p45: CAD file, 2026-10-27]
hardware/stl/device/coupling-clamp-left.stl
17.3 x 48.0 x 82.9
