KateredDesign/seedstick/hardware/stl/device/foot-jaw.stl

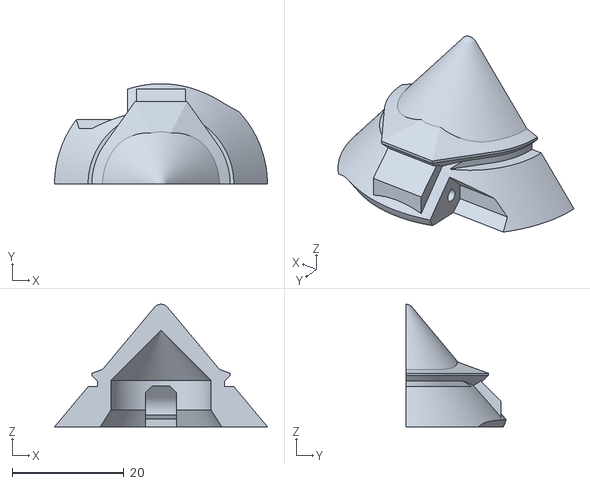
[picture p46: CAD file, 2026-10-27]
hardware/stl/device/foot-jaw.stl
38.2 x 18.0 x 22.0
