KateredDesign/seedstick/hardware/stl/device/oled-bracket.stl

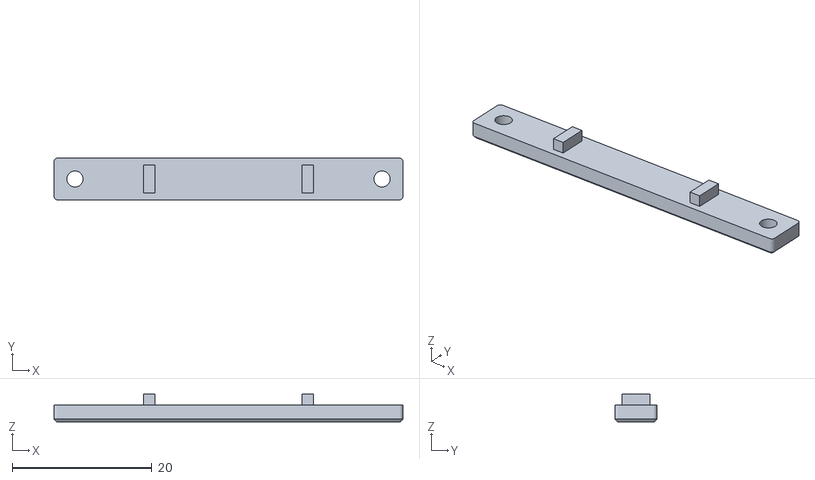
[picture p47: CAD file, 2026-10-27]
hardware/stl/device/oled-bracket.stl
50.0 x 6.00 x 4.00
