KateredDesign/seedstick/hardware/stl/device/grip-sleeve.stl

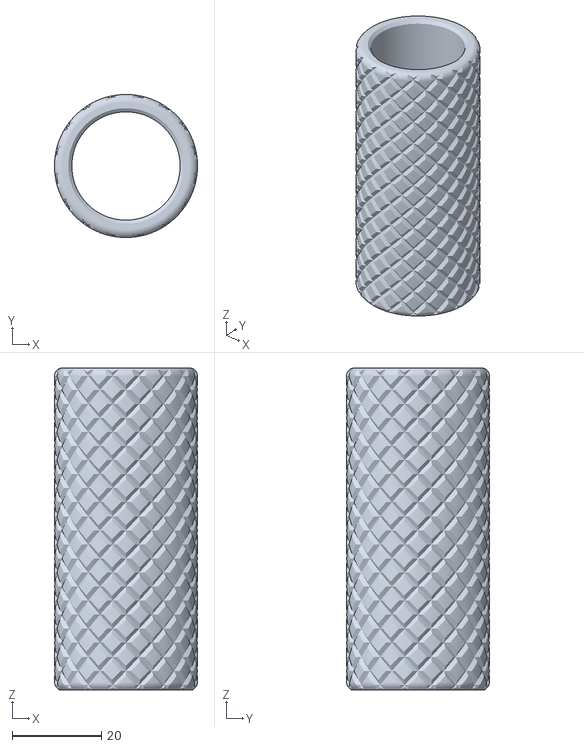
[picture p48: CAD file, 2026-10-27]
hardware/stl/device/grip-sleeve.stl
32.0 x 32.0 x 72.0
