KateredDesign/seedstick/hardware/stl/device/metering-housing.stl

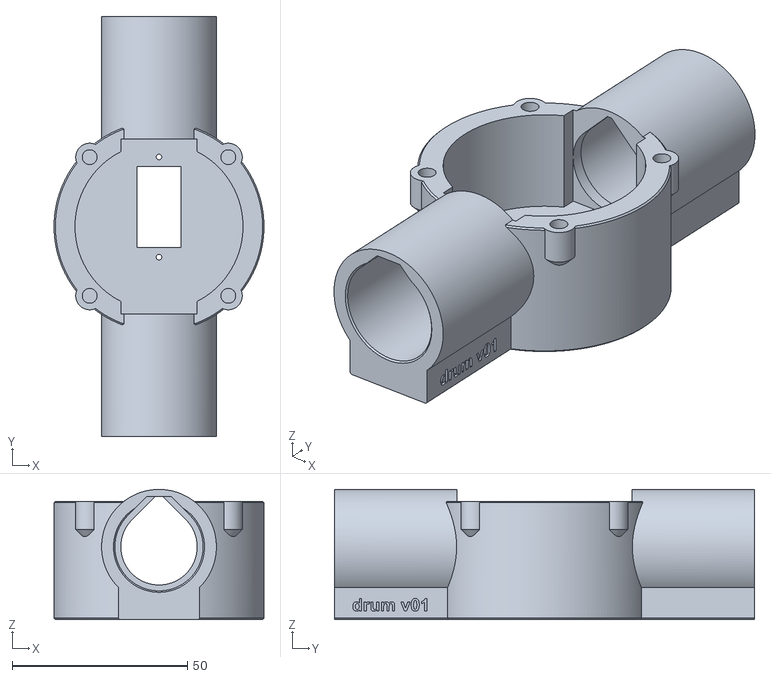
[picture p49: CAD file, 2026-10-27]
hardware/stl/device/metering-housing.stl
60.0 x 120.0 x 37.2
