KateredDesign/seedstick/hardware/stl/device/handle-bar.stl

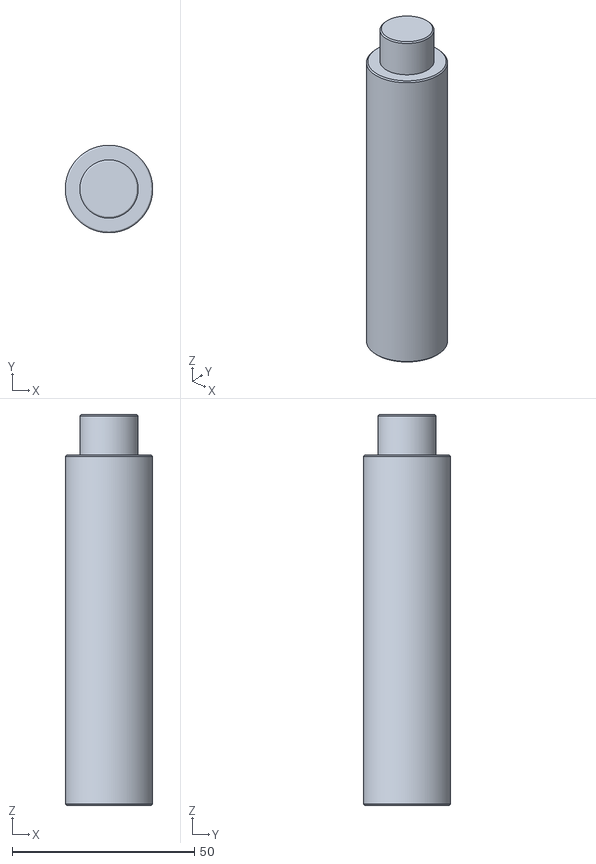
[picture p50: CAD file, 2026-10-27]
hardware/stl/device/handle-bar.stl
24.0 x 24.0 x 107.2
