KateredDesign/seedstick/hardware/stl/device/handle-clamp-cap.stl

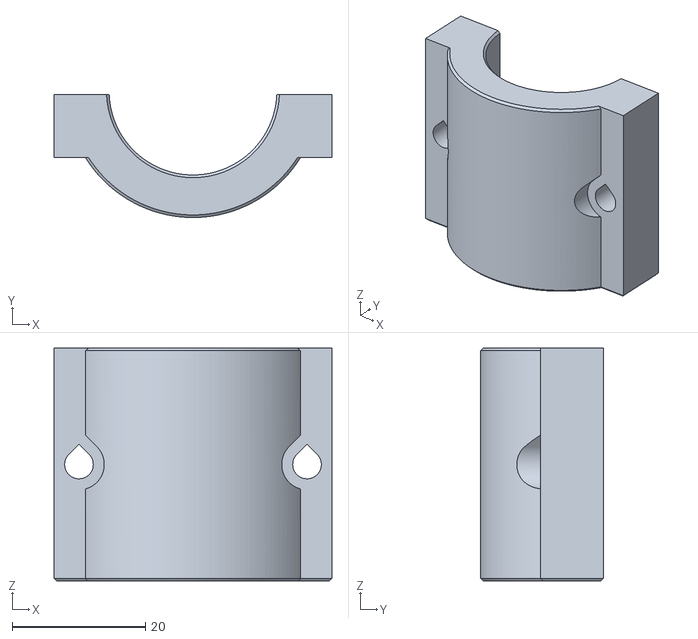
[picture p51: CAD file, 2026-10-27]
hardware/stl/device/handle-clamp-cap.stl
41.8 x 18.5 x 35.0
