KateredDesign/seedstick/hardware/stl/device/metering-wheel.stl

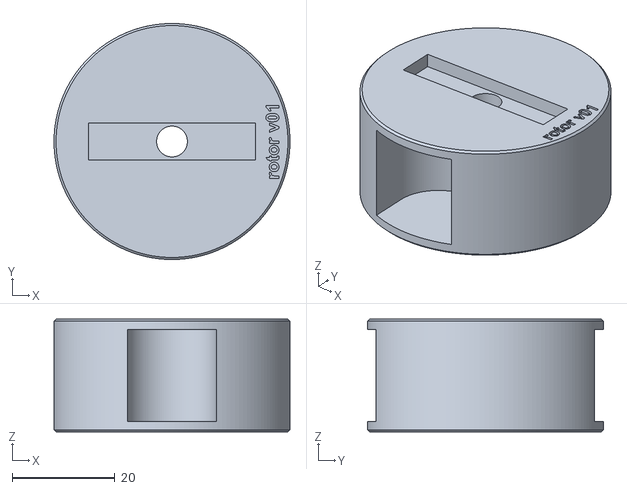
[picture p52: CAD file, 2026-10-27]
hardware/stl/device/metering-wheel.stl
46.0 x 46.0 x 22.0
