KateredDesign/seedstick/hardware/stl/device/handle-head.stl

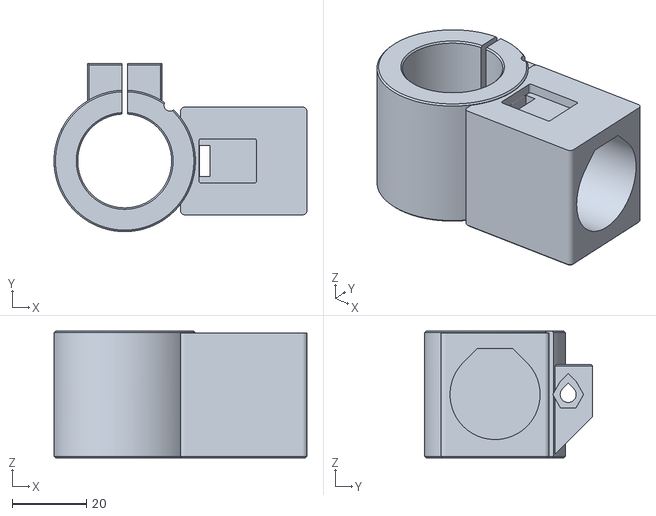
[picture p53: CAD file, 2026-10-27]
hardware/stl/device/handle-head.stl
68.0 x 45.2 x 34.0
