KateredDesign/seedstick/hardware/stl/device/handle-housing.stl

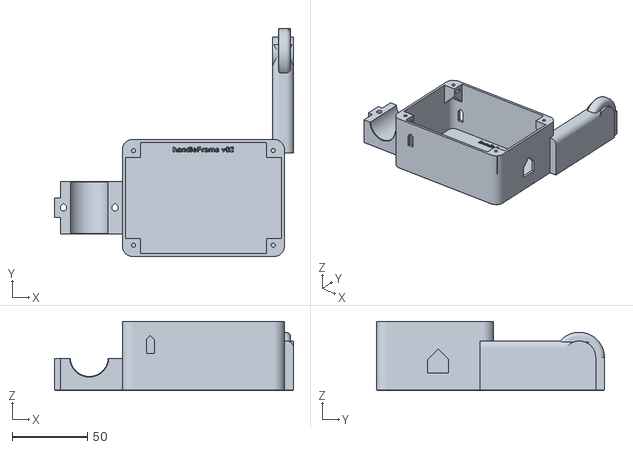
[picture p54: CAD file, 2026-10-27]
hardware/stl/device/handle-housing.stl
159.1 x 151.8 x 46.0
