KateredDesign/seedstick/hardware/stl/device/sensor-holder-back.stl

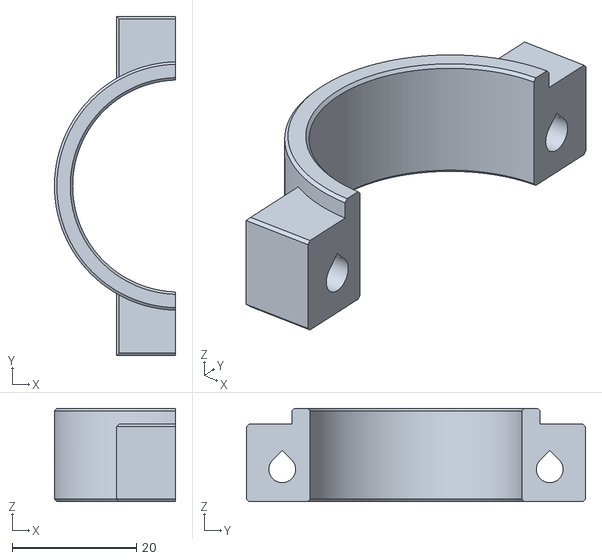
[picture p55: CAD file, 2026-10-27]
hardware/stl/device/sensor-holder-back.stl
19.5 x 54.6 x 15.0
