KateredDesign/seedstick/hardware/stl/device/transport-cap.stl

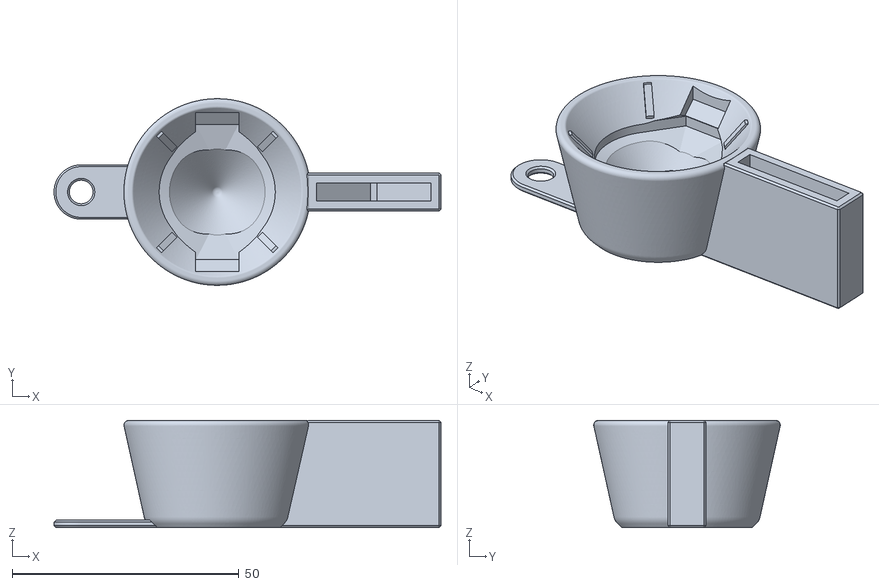
[picture p56: CAD file, 2026-10-27]
hardware/stl/device/transport-cap.stl
85.3 x 41.2 x 23.6
