KateredDesign/seedstick/hardware/stl/device/power-box-lid.stl

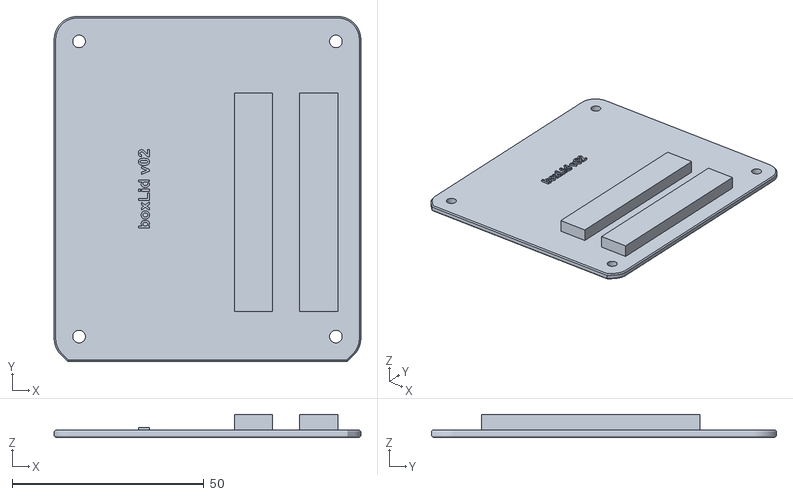
[picture p57: CAD file, 2026-10-27]
hardware/stl/device/power-box-lid.stl
80.0 x 90.0 x 6.00
