KateredDesign/seedstick/(list of files, cad)

Other CAD files:
hardware/stl/device/coupling-clamp-right.stl
