KateredDesign/seedstick/(notices)

Notices in the files:
README.md:
Hardware: CC BY 4.0
